tianlin-wang/rfid_reader_with_esp32/README.md

# 智能收作业系统（离线版）

基于 **ESP32-S3 + PN532** 的课堂作业登记器：学生把贴了 NTAG 标签的作业本往读卡器上一放，屏幕立刻登记，全程离线，数据存在 SD 卡里断电不丢。

> 早先版本只是个"读卡显示 UID"的演示器，现在是一个完整的收作业工具。老版本的功能（读卡 / NTAG 写卡）都保留了。

---

## 功能

- **刷卡登记** —— 作业本贴上 NTAG 标签，刷一下即登记，屏幕显示姓名、提交结果和全班进度条
- **专属编号** —— 每个学生自动发一个编号（`0001` 起），既存名单也写进卡片，刷卡时两边核对
- **防拿错卡** —— 卡里编号和名单对不上会当场拦下，并告诉你是谁的卡
- **未交名单** —— 按 C 键随时翻看谁还没交，分页显示
- **多次作业** —— 最多 30 次，全部交齐后自动进入下一次
- **断电记忆** —— 名单和提交记录都写成 CSV 存在 SD 卡里，拔电重启接着用
- **中文双字库** —— SD 卡放 `font.vlw`（抗锯齿）优先，不插卡自动回退内置 16×16 点阵
- **写卡模式** —— 批量给空白标签发编号，或给已登记的卡补写

## 硬件接线

### ST7789 TFT (240×240) —— SPI2 (FSPI)

| TFT Pin | ESP32 Pin |
|---|---|
| SCK | 4 |
| MOSI | 5 |
| RST | 6 |
| DC | 7 |
| CS | 10 |
| BLK | 13 |

### PN532 (SPI 模式) —— 软件 SPI

| PN532 Pin | ESP32 Pin |
|---|---|
| SCK | 17 |
| MISO | 18 |
| MOSI | 8 |
| SS | 3 |
| IRQ | 11 |
| RST | 12 |

> PN532 模块上的拨码开关要拨到 SPI 模式（SEL1=0，SEL2=1）。

### SD 卡 —— SPI（HSPI / 下标 1）

| SD Pin | ESP32 Pin |
|---|---|
| SCK | 42 |
| MISO | 41 |
| MOSI | 40 |
| CS | 39 |

> **注意**：屏幕和 SD 卡必须走不同的 SPI 主机（详见下面那段）。改成同一个主机会因为两边各自调用 `spi_bus_initialize()` 互相冲突，**SD 卡直接挂不上**。

### 按键（另一端接 GND，内部上拉）

| 按键 | ESP32 Pin | 功能 |
|---|---|---|
| A | 14 | 短按 = 开新作业 / 确认；**长按 1 秒 = 清空全部记录** |
| B | 15 | 上翻页 / 取消 |
| C | 16 | 切换到未交名单 / 下翻页 |

---

> **★ SPI 主机分配（ESP32-S3，别改错）**
>
> Arduino 核心在 S2/S3 上只维护 2 条 SPI 总线，`_spi_bus_array[]` 的**下标**是：
>
> | 下标 | 寄存器 | 宏 | 谁在用 |
> |------|--------|-----|--------|
> | 0 | `SPI2_BASE` | `FSPI` | 屏幕 ST7789（LovyanGFX 内部映射到下标 0）|
> | 1 | `SPI3_BASE` | `HSPI` | SD 卡 |
>
> **注意**：`FSPI`/`HSPI` 里的数字是**数组下标**，不是 IDF 的 `spi_host_device_t`。
> 千万别写 `SPIClass sdSPI(SPI1_HOST)` —— `SPI1_HOST=0` 会落到下标 0（`SPI2_BASE`），
> 正好和屏幕撞车，两个库各配一遍同一外设 → 屏幕/SD 全崩。
>
> ```cpp
> SPIClass sdSPI(HSPI);   // ← SD 卡用下标 1
> ```
>
> 补充：ESP32-S3 的 `SOC_SPI_PERIPH_NUM = 3`，IDF 里 `SPI1_HOST=0 / SPI2_HOST=1 / SPI3_HOST=2`，
> 但 Arduino 的 `FSPI/HSPI` 宏映射到的是 **SPI2_BASE / SPI3_BASE**（跳过了 SPI1）。
> 两套编号体系很容易混，改代码前先确认一下。

### ⚠️ SD 卡：是板载卡槽还是外接模块？

`ESP32S3 CAM LCD` 板子上**自带一个 microSD 卡槽**，它的引脚是焊死的。
如果你把卡插在**板载卡槽**里，就必须用**板子的 SD 引脚**（不是下面表里自己接的那组）。
`tools/inspect_vlw.py` 也支持直接扫盘符：`python tools/inspect_vlw.py E:`。

挂载失败时按顺序查：

| 现象 | 原因 | 处理 |
|---|---|---|
| 5 个频率全失败 | 卡是 **exFAT** | 格式化成 **FAT32**（单分区）|
| 5 个频率全失败 | 接线/引脚不对 | 确认是板载卡槽还是外接模块，引脚别搞反 |
| 5 个频率全失败 | 供电不足 | 带 AMS1117 稳压器的模块要 5V |

---

## 依赖库

Arduino IDE 库管理器里装：

- **Adafruit PN532** — by Adafruit
- **LovyanGFX** — by lovyan03

`SPI.h`、`SD.h`、`driver/gpio.h` 都是板载自带的。

---

## 串口连不上 / 没反应怎么查

本机接线：**USB-TTL 桥（CH340）接 UART0**，即 GPIO44(收) / GPIO43(发)。
`Serial0` 就是 UART0；`Serial`（USB CDC）在这块板子上用不了，固件默认也不走它。

### 1. 先看端口对不对

设备管理器 / 终端里查：

```
USB-SERIAL CH340 (COM3)    <- 实际是这个
```

> `参数.xlsx` 里写的 COM4 是旧值，**别照着选**。
> Arduino IDE 右下角或「工具 → 端口」里选实际枚举出来的那个。

### 2. 波特率 115200

UART0 是真串口，波特率必须对。串口监视器右下角设置成 **115200**。

### 3. 烧录完按一下 RESET

固件只在开机时打一次 banner。中途打开监视器看不到是正常的——
所以固件加了**每 5 秒一次的心跳**：

```
[alive] t=5s heap=186KB mode=刷卡登记 sd=OK nfc=OK students=0
[alive] t=10s heap=186KB mode=刷卡登记 sd=OK nfc=OK students=0
```

看到这行 = 串口通。看不到 = 端口/波特率/接线有一处不对。

### 4. 还是没反应？按这个顺序排

| 现象 | 原因 | 怎么办 |
|---|---|---|
| 监视器一片空白，但屏幕正常显示 | 端口选错 / 波特率不对 | 回到第 1、2 步 |
| 有心跳但敲命令没反应 | 串口监视器行尾设成了 `No line ending` | 改成 `Both NL & CR`；固件已做超时兜底，但仍建议改 |
| 烧录时提示找不到端口 | CH340 驱动没装 | 装 CH340 驱动 |
| 板子上电完全没反应（屏幕也不亮） | 固件没跑起来 | 看屏幕右下角有没有绿点闪烁（心跳），有就说明程序活着 |

### 5. 桥接芯片不在默认引脚上？

UART0 默认是 GPIO44(收)/GPIO43(发)。如果你那块板的 USB-TTL 桥接到了别的引脚，
改 `sketch_sep6a.ino` 顶部这两行（RX 在前、TX 在后）：

```cpp
#define UART0_RX_PIN -1
#define UART0_TX_PIN -1
```

比如桥接在 GPIO11/12：`#define UART0_RX_PIN 11` / `#define UART0_TX_PIN 12`。

---

## 编译烧录

1. Arduino IDE 开发板选 **ESP32S3 Dev Module**（参照根目录 `参数.xlsx` 的完整配置：16MB Flash、QIO 80MHz、USB CDC On Boot 启用等）
2. 打开 `sketch_sep6a.ino` 编译烧录
3. 打开 **串口监视器**，波特率 **115200**

> `font_cn.h` 约 770 KB 源码 / 120 KB flash，编译会慢一点，属正常现象。

### ⚠️ 两个会让人怀疑人生的编译坑（已踩过）

**1. 文件开头不能有 UTF-8 BOM**

`sketch_sep6a.ino` 一旦带 BOM（`EF BB BF`），Arduino 的预处理会把 BOM 当成一个
不可见字符拼在第一行 `#define` 前面，于是报：

```
sketch_sep6a.ino:1:4: error: stray '#' in program
sketch_sep6a.ino:1:1: error: '<U+FEFF>' does not name a type
```

更坑的是**这一个 BOM 会干掉整个文件里所有的 `#define`**，于是后面跟着一串
`TFT_SCK was not declared`、`HardwareI2C does not name a type`、
`invalid new-expression of abstract class type`……看起来像几十个错误，其实只有一个原因。

用 VS Code / Notepad++ 编辑时请确认编码是 **UTF-8（无 BOM）**。
检查办法（PowerShell）：

```powershell
$b=[IO.File]::ReadAllBytes("sketch_sep6a.ino")[0..2]
if($b[0]-eq 0xEF -and $b[1]-eq 0xBB -and $b[2]-eq 0xBF){"有BOM"}else{"没BOM"}
```

**2. `#include <SD.h>` 必须写在 `#include <LovyanGFX.hpp>` 之前**

LovyanGFX 是靠 `#if defined(_SD_H_)` 判断"用户用了 SD 库"，才去生成
`DataWrapperT<fs::SDFS>` 这个特化。如果 `LovyanGFX.hpp` 先被包含，`_SD_H_`
还没定义，特化就不会生成，`lcd.loadFont(SD, path)` 会报：

```
invalid new-expression of abstract class type 'lgfx::v1::DataWrapperT<fs::SDFS>'
```

当前 `.ino` 顶部的顺序已经是 `SPI.h → SD.h → Adafruit_PN532.h → LovyanGFX.hpp`，
**别去动这个顺序**。

---

## 使用流程

### 第一次：登记学生

1. SD 卡插好，上电。检测不到名单会自动进入**登记模式**
2. 依次刷每个学生的贴纸，串口监视器输入 `name=张三`
3. 全部录完输入 `d` 保存退出

串口命令（登记模式下）：

| 命令 | 作用 |
|---|---|
| `name=名字` | 给刚刷的贴纸命名并加入名单 |
| `d` | 完成登记，保存到 SD 卡 |
| `list` | 打印当前名单 |
| `clear` | 清空名单 |

### 日常：收作业

| 操作 | 效果 |
|---|---|
| 刷作业本 | 登记，屏幕绿字"提交成功" + 进度条 |
| 重复刷 | 黄字提示"这次已经交过了"，不会重复计数 |
| 刷陌生卡 | 红字提示"未登记的卡"，并显示 UID |
| 按 C | 查看未交名单，B/C 翻页 |
| 全部交齐 | 自动跳到下一次作业 |
| 按 A | 确认后手动开新作业 |
| **长按 A** | 清空所有作业记录（名单保留） |

### 串口模式切换（任何时候）

| 命令 | 作用 |
|---|---|
| `s` | 进入登记模式 |
| `w` | 进入写卡模式（发编号 / 补写） |
| `r` | 回到刷卡登记 |
| `t` | 状态页：看各模块运行状况（没指示灯就看这个） |
| `probe` | 读卡器自检：连扫 10 秒，打印每张卡的 UID 和卡内编号 |
| `list` | 查看名单（含编号） |
| `h` | 命令帮助 |

---

## 硬件没到齐怎么先跑起来

按键和读卡器都不影响开机：**PN532 检测不到时不再卡死**，而是进入「无卡模式」——屏幕、中文字库、SD 存档、名单管理全部正常工作，只是读不到真实卡片。

所有按键操作都有对应的串口命令，没按键时直接敲命令就行：

| 按键 | 串口命令 | 效果 |
|---|---|---|
| A（短按） | `n` | 开新作业 / 确认 |
| B | `u` | 上翻页 / 取消 |
| C | `m` | 未交名单 / 下翻页 |

模拟刷卡（读卡器没到时用）：

```
sim=张三          # 模拟刷张三的卡，走完整登记流程
sim=04 A2 3F 1B  # 模拟刷指定 UID
sim?             # 模拟刷一张未登记的卡
```

其它命令：`s` 登记模式、`w` 写卡模式、`r` 回刷卡界面、`probe` 读卡器自检、`h` 帮助。

---

## 读卡器到货后的首次上机检查

按顺序做，每一步都有明确的"对了应该看到什么"。

### 1. 拨码开关拨到 SPI（最容易翻车的一步）

PN532 模块上两个拨码开关，要拨到 **SEL1=0 / OFF，SEL2=1 / ON**。
不同厂家的丝印不一样，如果板子上标的是 `SEL0/SEL1`，按这个表对：

| 想要 | SEL0 | SEL1 |
|---|---|---|
| SPI（我们要的） | 0 | 1 |
| I2C | 1 | 0 |
| HSU 串口 | 0 | 0 |

拨完**必须断电重上电**才生效。

### 2. 接线

最少接 6 根就能验证（`IRQ` 本工程没用到，可以先不接）：

| PN532 | ESP32 |
|---|---|
| VCC | 3.3V（板子带稳压的接 5V 也行，但**别两种同时接**） |
| GND | GND |
| SCK | 17 |
| MISO  | 18 |
| MOSI  | 8 |
| SS | 3 |
| RST | 12 |

> 这四根信号线走的是**软件 SPI**（库里按位模拟），所以任意 GPIO 都行，
> 不必是芯片的硬件 SPI 引脚。

### 3. 编译前先装依赖

`Adafruit_PN532` 会无条件 include `Adafruit_I2CDevice.h`。
库管理器里装 **Adafruit I2C Device**，否则报
`fatal error: Adafruit_I2CDevice.h: No such file`。

### 4. 看开机日志 / 状态页

烧录完打开串口监视器（**115200**）。**正确的**输出是：

```
Init PN532...
PN532 F/W 1.6        <- 这行出现说明读卡器和拨码开关都对
```

如果看到的是
`WARN: PN532 not found - running WITHOUT reader`，
说明没连上，回到第 1 步重新确认开关和接线。

#### 串口不通？先看屏幕上的 RX/TX

固件在**刷卡界面**和**登记界面**底部都常驻一行：

```
RX:0 TX:142 last:'.'
```

| 现象 | 结论 | 怎么办 |
|---|---|---|
| `RX` 一直是 0，但你在串口里敲了字 | **电脑 → 板子** 断了 | 换端口 / 换波特率 / 检查 CH340 的 TX 是否接到板子 **RX(GPIO44)** |
| `TX` 在涨，串口监视器却空白 | **板子 → 电脑** 断了 | 端口选错、TX/RX 接反、或 CH340 没共地 |
| `RX` 在涨，`last` 显示你敲的字符 | 双向都通 | 串口没问题，去查别的 |

> 板子丝印上 **TX=GPIO43、RX=GPIO44**。
> CH340 那头要**交叉**接：CH340 的 TX → 板子 RX，CH340 的 RX → 板子 TX，GND 必须共地。
> 接反的话：板子发的进不了电脑，电脑发的也进不了板子。

#### 板子上没有指示灯怎么看运行状况？

**屏幕就是指示灯。** 开机后屏幕会先弹一个**状态页**，一屏看清每个环节：

```
系统状态
屏幕    OK  ST7789
读卡器  OK  PN532 F/W 1.6     <- 绿=正常，红=没找到
SD卡    OK                    <- 绿=正常，红=挂载失败
字库    vlw (卡上)             <- 黄=退回内置点阵
学生    0 人
作业    第 1 次
已交    0 / 0
t 返回  h 帮助
```

- 一切正常 → 4 秒后自动回到刷卡界面
- **有红字 → 状态页会一直停着不动**，因为出问题的就是它，去修那一项
- 串口随时敲 **`t`** 可以再调出状态页（再敲一次关掉）

串口敲 `t` 还会打印一份更详细的报告：

```
---- 系统状态 ----
  屏幕      : OK  ST7789 240x240
  读卡器    : OK  PN532 F/W 1.6
  SD 卡     : OK
  字库      : vlw（卡上 /font.vlw）
  学生      : 0 人
  当前作业  : 第 1 次，已交 0/0
  界面模式  : 刷卡登记
  运行      : 已启动 12 秒，空闲内存 180 KB
  提示      : t 状态页  h 帮助  probe 读卡器自检  list 名单
-------------------
```

**字库显示"内置点阵"** 说明 SD 卡上没有 `/font.vlw`（或 SD 挂载失败）。
内置点阵能显示中文，只是没有抗锯齿、比较糙。把 `font.vlw` 拷到 SD 卡根目录即可。

#### 想自己加一颗指示灯？

代码里留了接口。把一颗 LED（串 220~330Ω 电阻）接到**任意一个空闲 GPIO** 和 GND 之间，
然后改这一行：

```cpp
#define LED_PIN -1     // 改成你接的那个 GPIO 号，比如 21
```

灯的含义：常亮=一切正常；慢闪=读卡器没接上；快闪=SD 卡挂了；双闪=登记模式。
默认 `-1`（关闭），不接灯也能正常跑。

### 5. 用 probe 确认能读到卡

串口敲 `probe`，它会连续扫 10 秒，把卡放上去：

```
probe: 连续扫描 10 秒，把卡片放上去...
  卡 #1 UID: 04 A2 3F 1B  (4 字节)  卡内无编号（空白卡 / 非本系统）  名单:未登记
probe 结束，共识别 1 张卡
```

一张都没读到时会直接列出排查清单（开关 / 接线 / 卡片类型）。

> 只认 **ISO14443A** 的卡：NTAG213/215/216、Mifare 系列都行；
> **身份证、门禁卡、银行卡读不到**（那些是别的协议或做了加密）。

### 6. 跑通完整流程

```
s            进登记模式
（刷卡）     串口打印 UID，提示输入姓名
name=张三    自动分配编号 0001，写入卡片并读回校验
name=李四    编号 0002，依此类推
d            登记完成，回到刷卡界面
（刷卡）     登记作业，屏幕显示 [0001] 张三 提交成功
m            看谁还没交
```

写进 SD 卡的 `/roster.csv` 长这样：

```
# UID_HEX,SID,NAME
04 A2 3F 1B,1,张三
```

### 7. 验证防拿错卡

把两张卡互换着刷一次，应该弹「编号不符」并提示是哪位同学的卡。。

硬件到齐后接上即可，串口命令和按键可以混用，不需要改代码。

---

## SD 卡上的文件

| 文件 | 内容 |
|---|---|
| `/font.vlw` | 中文字库（可选，没有就用内置点阵）。**文件名不强制**，卡根目录任意 `.vlw` 都会被自动采用 |
| `/roster.csv` | `UID_HEX,编号,姓名` 学生名单（旧的两列格式能自动兼容并补号） |
| `/state.csv` | 当前是第几次作业 |
| `/hw_N.csv` | 第 N 次作业的提交记录（`姓名,UID,是否提交`） |

直接拔卡插电脑就能导出名单做统计。

---

## 专属编号与写卡

每个学生有一个**专属编号**（1~50，按登记顺序自动分配，显示成 `0001` 这样），
这个编号既存在名单里，也**写进卡片**。刷卡时两边一起核对，
能当场抓出「拿错卡」「换卡」的情况。

### 卡片里存了什么

只占 2 页，写入和校验都很快：

| 页 | 内容 |
|----|---|
| 第 8 页 | `'R' 'F' 'I' 'D'` 魔数，一眼认出是我们的卡 |
| 第 9 页 | 版本号 \| 编号高字节 \| 编号低字节 \| 校验和 |

校验和是前 7 个字节按位异或，卡片写坏或读到脏数据时会直接被拦下。

| 型号 | 用户页范围 |
|---|---|
| NTAG213 | 4 ~ 39 |
| NTAG215 | 4 ~ 129 |
| NTAG216 | 4 ~ 225 |

### 怎么发号

**方式一：登记时自动写卡（推荐）**

串口 `s` 进登记模式，刷卡 → 输入 `name=张三`，
系统自动分配编号并**顺手把编号写进这张卡**，写完立刻读回校验。
一张卡一步搞定，不用再单独跑写卡模式。

**方式二：批量写卡 / 补写**

串口 `w` 进写卡模式，一张一张往上放：

- **没登记过的卡** → 自动分配下一个空闲编号并写入
- **已经登记过的卡** → 把它的编号重写回去（卡片蹭坏了、想补号时用）

写卡界面会显示"下一个将分配编号 00XX"，不用记自己数到哪了。

### 刷卡时的核对

UID 对上名单只是第一步，程序还会读回卡内编号再比一次：

| 情况 | 屏幕显示 |
|---|---|
| 编号一致 | 正常记录提交，姓名上方显示 `[0007]` |
| 卡里是别人的编号 | `编号不符`，并直接告诉你是谁的卡 |
| 卡里没编号 | `卡里没有编号`，提示可能没写过 |

这种核对能防止别人替交作业——只拿卡不刷对不上的号会被拦下。

> ⚠️ **依赖提醒**：`Adafruit_PN532` 库会无条件 include `Adafruit_I2CDevice.h`，
> 即使你用软件 SPI 用不到 I2C 也一样。编译报
> `Adafruit_I2CDevice.h: No such file` 时，在库管理器里装一下
> **Adafruit I2C Device** 即可。

---

## 中文字库：vlw 优先，点阵兜底

两种方案会自动选择，**SD 卡上有 `.vlw` 就用 vlw**：

| 方案 | 条件 | 特点 |
|---|---|---|
| **SD 卡 vlw**（优先） | 卡根目录存在 `.vlw` 文件 | 8bit 抗锯齿灰度，观感最好；换字体/字号重新生成就行 |
| **内置点阵**（兜底） | 没插卡 / 卡上没有 `.vlw` | 16×16 点阵编译进 flash，任何情况都能显示中文 |

**文件名不强制叫 `font.vlw`。** 固件优先找 `/font.vlw`；找不到就扫 SD 卡根目录，
拿第一个 `.vlw` 来用（大小写不敏感）。你从网上下载的 VLW 直接丢进卡根目录即可，
不用改名。

开机串口会打印用的是哪一套：

```
Font: vlw loaded (/font.vlw), native line height=16, scale=1.00
Font: no .vlw on card, using built-in bitmap
Font: 这个文件不是 VLW 格式（可能是 .ttf 改了后缀）
```

串口敲 `ls` 可以看卡上到底有什么文件。

### 检查自己下载的 .vlw 能不能用

`tools/inspect_vlw.py` 零依赖，完全照抄 LovyanGFX 的解析算法，
在电脑上就能判断这个字库能不能被板子接受：

```bash
python tools/inspect_vlw.py D:/          # 扫 D 盘根目录所有 .vlw
python tools/inspect_vlw.py D:/your.vlw  # 看单个文件
```

输出示例：

```
字形数 : 3883    格式版本: 0
实际行高: 16   (ascent 13 + descent 3)
理论总长: 929065 字节 / 实际 929065 字节  ->  一致
覆盖  : ASCII 95, 常用汉字 3756, 其它 32
常用字抽查: 全部齐全
行高 16 —— 和 UI 设计的 16px 完全一致，不缩放，效果最好
```

三个红字信号：

| 提示 | 含义 |
|---|---|
| `这不是 VLW，是 TrueType (.ttf)` | 下载的是 .ttf，改后缀没用。要用 `gen_font_cn.py` 转 |
| `理论总长 != 实际大小` | 文件没拷全 / 损坏 |
| `缺这些常用字: …` | 这个 vlw 不含中文，UI 会显示成空白 |

**行高不等于 16 也能用**——固件会自动缩放到 16px，尺寸对但可能略糊。

### ⚠️ 为什么放的是 .vlw 而不是 .ttf

LovyanGFX 的 TTF 解码器在官方仓库的**可选文件** `lgfx_ttffont.hpp` 里，
Arduino 库管理器装的发行版**没有它**。没有它时，库把所有字体文件一律按
VLW 格式解析（见 `lgfx_fonts.cpp` 里的 `#ifdef LGFX_TTFFONT_HPP_`），
往卡里塞 `.ttf` 只会加载失败或显示乱码。

`.vlw` 本来就是「用任意 TTF 在电脑上预渲染出来的字体文件」——
想换微软雅黑、思源黑体等任何字体，改一下生成脚本的 `--font` 参数即可，
效果等同于矢量字体。

### 生成字库

```bash
cd tools
pip install Pillow
python gen_font_cn.py --preview font_preview.png
# 或者直接写进 SD 卡：python gen_font_cn.py --vlw E:\font.vlw
```

脚本一次产出两个文件：

- `font.vlw`（约 900 KB）→ 拷到 SD 卡根目录
- `font_cn.h`（编译进 flash 的点阵兜底，约 120 KB flash）

字符集自动包含：ASCII + GB2312 一级汉字（3755 个）+ 常用标点 +
**扫描 `.ino` 源码里出现过的所有汉字**（以后改 UI 文案也不怕缺字）。
默认源字体 `C:\Windows\Fonts\simhei.ttf`，想换加 `--font` 参数；
字号默认自动选到 16px 行高以内，想指定用 `--size`。
生成后可以用 `verify_vlw.py` 离线渲染检查（它完全照抄库里的解析算法）：

```bash
python verify_vlw.py ../font.vlw vlw_check.png
```

---

## 代码结构

```
sketch_sep6a.ino
├── 引脚定义          屏幕 / PN532 / SD / 按键
├── 数据模型          Student 结构（uid + 编号 + 姓名）、提交位图 (50 人 × 30 次)
├── 按键中断          gpio_get_level + esp_timer_get_time，IRAM 安全
├── 存储层            SD 卡 CSV 读写（roster / state / hw_N）
├── 字库引擎          SD 卡 vlw（抗锯齿）/ 内置 font_cn.h 点阵，自动切换
├── 绘图原语          fillRect / drawFastHLine / printCentered / printRight
├── UI 画面           刷卡 / 未交名单 / 登记 / 写卡 / 编号不符
├── 编号与写卡        nextFreeSid / writeCardSid / readCardSid（含校验和与回读核对）
└── loop()            状态机 + 串口命令解析
```

---

## 已知限制

- 写卡仅支持 **NTAG** 系列（Ultralight 协议），Mifare Classic 写卡暂未加入
- 编号是顺序号（1~50），中途删人不会重排编号，避免已发出的卡对不上
- 字库只收了 GB2312 一级汉字，姓名里出现生僻字会显示成方框
- 刷卡时每次都要读回卡片做编号核对，比只看 UID 慢约 30ms

---

## License

MIT
