tianlin-wang/rfid_reader_with_esp32/tools/font_preview.png

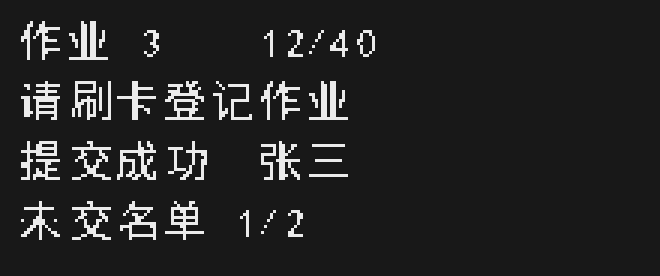
tools/font_preview.png
