tianlin-wang/rfid_reader_with_esp32/tools/vlw_check.png

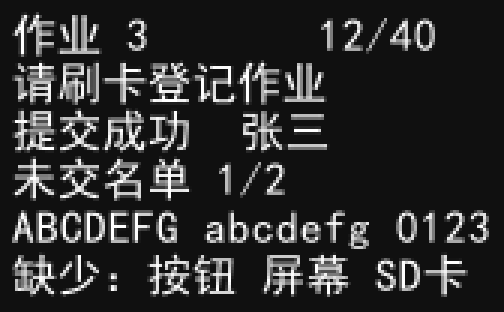
tools/vlw_check.png
