tianlin-wang/rfid_reader_with_esp32/sketch_sep6a.ino

#define TFT_SCK    4
#define TFT_MOSI   5
#define TFT_RST    6
#define TFT_DC     7
#define TFT_CS     10
#define TFT_BLK    13

#define PN532_SCK  17
#define PN532_MISO 18
#define PN532_MOSI 8
#define PN532_SS   3
#define PN532_IRQ  11
#define PN532_RST  12

#define BTN_NEXT  14
#define BTN_UP    15
#define BTN_DOWN  16

// ---- SD 卡 ----
// 现在这组是「外接 SD 模块」的自定接线。
// 如果你把卡插在**板载卡槽**里，卡槽的引脚是焊死的，必须按板子丝印改下面 4 行。
// ⚠️ 板载卡槽如果是 SPI 模式，通常在 GPIO 10/11/12/13 上 ——
//    而这 4 个脚已经被 TFT_CS(10) / PN532_IRQ(11) / PN532_RST(12) / TFT_BLK(13) 占了，
//    会打架。想用板载卡槽，得先把上面的 PN532/TFT 引脚挪开。
#define SD_SCK    42
#define SD_MISO   41
#define SD_MOSI   40
#define SD_CS     39

// ★ 顺序不能改：LovyanGFX 靠 `defined(_SD_H_)` 来决定是否为 fs::SDFS 生成
//   DataWrapperT 特化。SD.h 必须在 LovyanGFX.hpp 之前包含，否则
//   lcd.loadFont(SD, path) 会报 “invalid new-expression of abstract class type”。
#include <SPI.h>
#include <SD.h>
#include <Adafruit_PN532.h>
#include <LovyanGFX.hpp>
#include "driver/gpio.h"
#include "esp_timer.h"

// ============ 串口控制台 ============
// 板上没有指示灯，串口是唯一能看到"系统在干什么"的窗口，这块必须稳。
//
// 本机情况：**只有 UART0 能用**（USB-TTL 桥接在 GPIO44 收 / GPIO43 发）。
//   Serial0 = HardwareSerial(0) = UART0，串口监视器连的就是它。
//   Serial  = USB CDC（USB CDC On Boot=1 时是 HWCDCSerial），本板用不了。
//
// 三个已知的坑：
//  1) Serial0.printf() 没被 HardwareSerial 重写，走的是 Print::printf ->
//     vprintf -> stdout -> SDK 控制台，和 println 不是同一条路，容易混。
//     所以这里自己实现 printf，保证所有输出走同一条路。
//  2) 不能写 while (!Serial0) delay(10); —— USB CDC 那种"等主机连上"的行为
//     会让没开监视器就上电的板子永远卡住，表现为"板子没反应"。
//     所以 operator bool() 永远返回 true。
//  3) 串口监视器行尾设成 "No line ending" 时，readStringUntil('\n') 会一直等。
//     所以自己实现带超时的版本，收到什么算什么。
//
// 想同时开 USB CDC：把 LOG_MIRROR_USB 改成 1（收发都走两个口）。
#define LOG_MIRROR_USB 0

// 如果你的 USB-TTL 桥不是接在芯片默认的 GPIO44(收)/GPIO43(发)，
// 把实际引脚填进来（RX 在前、TX 在后），-1 表示用默认值。
// 例如桥接在 GPIO11/12 时：#define UART0_RX_PIN 11
#define UART0_RX_PIN -1
#define UART0_TX_PIN -1

class DualConsole : public Print {
public:
  void begin(unsigned long baud) {
#if UART0_RX_PIN >= 0 && UART0_TX_PIN >= 0
    Serial0.begin(baud, SERIAL_8N1, UART0_RX_PIN, UART0_TX_PIN);
#else
    Serial0.begin(baud);
#endif
#if LOG_MIRROR_USB && ARDUINO_USB_CDC_ON_BOOT
    Serial.begin(baud);
#endif
  }
  void setTimeout(unsigned long t) { Serial0.setTimeout(t); }

  // 永远 true。不能像 USB CDC 那样"等主机连上才 true"，
  // 否则没开串口监视器就上电的板子会永远卡在 while (!串口) 上，表现为"没反应"。
  operator bool() const { return true; }

  size_t write(uint8_t c) override {
    size_t n = Serial0.write(c);
    txBytes++;
    usbPut((const char *)&c, 1);
    return n;
  }
  size_t write(const uint8_t *buffer, size_t size) override {
    size_t n = Serial0.write(buffer, size);
    txBytes += size;
    usbPut((const char *)buffer, size);
    return n;
  }

  // 自己实现 printf：Print::printf 走 vprintf -> stdout，只会到 UART0
  size_t printf(const char *format, ...) __attribute__((format(printf, 2, 3))) {
    char buf[256];
    va_list ap;
    va_start(ap, format);
    int len = vsnprintf(buf, sizeof(buf), format, ap);
    va_end(ap);
    if (len < 0) return 0;
    if (len > (int)sizeof(buf) - 1) len = (int)sizeof(buf) - 1;
    return write((const uint8_t *)buf, (size_t)len);
  }

  int available() {
    int n = Serial0.available();
#if LOG_MIRROR_USB && ARDUINO_USB_CDC_ON_BOOT
    n += Serial.available();
#endif
    return n;
  }
  int read() {
    if (Serial0.available()) { rxBytes++; lastRx = (uint8_t)Serial0.read(); return lastRx; }
#if LOG_MIRROR_USB && ARDUINO_USB_CDC_ON_BOOT
    if (Serial.available()) { rxBytes++; lastRx = (uint8_t)Serial.read(); return lastRx; }
#endif
    return -1;
  }

  // 按行取命令：两个口的数据混在一起读，谁先来读谁。
  // 没有换行也能用（超时就把已收到的返回），所以串口监视器
  // 的行尾设置成 "No line ending" 也能敲命令。
  String readStringUntil(char term) {
    String s;
    uint32_t t0 = millis();
    while (millis() - t0 < 150) {
      int c = read();
      if (c < 0) { delay(1); continue; }
      if (c == term) break;
      if (c == '\r') continue;
      s += (char)c;
      if (s.length() >= 120) break;
    }
    return s;
  }

  // loop() 里调一次：USB 枚举好之后把缓存的启动日志补发出去
  void pump() {
#if LOG_MIRROR_USB && ARDUINO_USB_CDC_ON_BOOT
    if (usbLive) return;
    if (!Serial) return;
    usbLive = true;
    if (bufLen > 0) {
      Serial.write((const uint8_t *)buf, (size_t)bufLen);
      bufLen = 0;
    }
#endif
  }

  // 收发字节计数：屏幕上直接显示，用来判断串口到底通没通
  // （电脑->板子断了还是板子->电脑断了，看这两个数就知道）
  uint32_t rxBytes = 0;
  uint32_t txBytes = 0;
  uint8_t  lastRx = 0;

private:
  static const int CAP = 2048;
  char buf[CAP];
  int bufLen = 0;
  bool usbLive = false;

  void usbPut(const char *s, size_t n) {
#if LOG_MIRROR_USB && ARDUINO_USB_CDC_ON_BOOT
    if (usbLive) { Serial.write((const uint8_t *)s, n); return; }
    for (size_t i = 0; i < n && bufLen < CAP; i++) buf[bufLen++] = s[i];
#endif
  }
};

DualConsole LOG;

Adafruit_PN532 nfc(PN532_SCK, PN532_MISO, PN532_MOSI, PN532_SS);

// ★ ESP32-S3 上 SPI 的分配（这里踩过坑，务必别改错）
//
// Arduino 核心在 S2/S3 上只维护 2 条 SPI 总线，`_spi_bus_array[]` 的**下标**是：
//   [0] = DR_REG_SPI2_BASE   （宏 FSPI = 0）→ 屏幕在用（LovyanGFX 内部映射到下标 0）
//   [1] = DR_REG_SPI3_BASE   （宏 HSPI = 1）→ SD 卡在用
//
// 注意：FSPI/HSPI 里的数字是**数组下标**，不是 IDF 的 spi_host_device_t！
// 千万别写 `SPIClass sdSPI(SPI1_HOST)` —— SPI1_HOST=0 会落到下标 0（SPI2_BASE），
// 正好和屏幕撞车，两个库各配一遍同一外设 → 屏幕/SD 全崩。
// 就用 Arduino 的宏 HSPI 给 SD，FSPI 给屏幕。
SPIClass sdSPI(HSPI);
bool sdReady = false;

// 读卡器没到货 / 没接时置 false：setup() 不再卡死，进入"无卡模式"，
// 名单、作业状态、屏幕、SD 存档都能先用串口验证。
bool nfcReady = false;

// PN532 固件版本（setup 时读到）。0 = 没读到。
uint32_t nfcFwVer = 0;

// 实际加载的 VLW 文件名（状态页要显示）
char fontName[48] = "";

// 心跳点：屏幕右下角的小方块，每 5 秒翻一次颜色。
// 板上没有指示灯，这是"程序还活着"最直观的证据。
bool beatToggle = false;

// ============ 状态页（顶替不存在的指示灯） ============
// 板子上没有 LED 时，"系统现在跑到哪一步了"只能靠屏幕和串口来判断。
// 开机先弹这个状态页，串口敲 t 随时可以再调出来。
bool statusViewActive = false;
uint32_t statusViewUntil = 0;   // 0 = 一直停着，直到再按一次 t 切回

// 可选状态灯：接一颗 LED（串 220~330Ω 电阻）到任意一个空闲 GPIO 和 GND 之间，
// 然后把下面的数字改成那个 GPIO 号即可。-1 = 关闭（默认）。
// 常亮=正常；慢闪=读卡器没接上；快闪=SD 卡挂载失败；双闪=登记模式。
#define LED_PIN -1

// ============ 颜色 ============
#define BLACK   0x0000
#define WHITE   0xFFFF
#define RED     0xF800
#define GREEN   0x07E0
#define BLUE    0x001F
#define CYAN    0x07FF
#define YELLOW  0xFFE0
#define GRAY    0x8410   // 次要信息（UID、页码），别跟正文抢注意力

// ============ 数据模型 ============
#define MAX_STUDENTS 50
#define MAX_HOMEWORK 30
#define BITS_PER_HW  7

struct Student {
  uint8_t uid[7];
  uint8_t uidLen;
  // 专属编号，1~MAX_STUDENTS，登记时按顺序自动分配。
  // 同时写进卡片用户页，刷卡时读回来和这里比对，能抓出拿错卡/换卡。
  uint16_t sid;
  // 16 字节 = 5 个汉字（UTF-8 3 字节/字）+ 结束符。
  // 原来是 12 字节，只能塞 3 个汉字，四个字的名字会被截断。
  char name[16];
};

enum SystemMode { MODE_CHECKIN, MODE_MISSING, MODE_SETUP, MODE_WRITE, MODE_CONFIRM_NEW };
SystemMode sysMode = MODE_CHECKIN;

Student roster[MAX_STUDENTS];
uint8_t studentCount = 0;
uint8_t currentHW = 0;
uint8_t submissions[MAX_HOMEWORK][BITS_PER_HW];

// ============ 按钮（ISR 置标志，loop 里处理） ============
volatile bool btnNextFlag = false;
volatile bool btnUpFlag = false;
volatile bool btnDownFlag = false;
volatile unsigned long btnNextPressTime = 0;
volatile bool btnNextLongPress = false;

// 中断里不能调 digitalRead() / millis()：它们不在 IRAM 里，
// flash 被占用时会崩。改用 gpio_get_level() 和 esp_timer_get_time()。
static inline unsigned long isrMillis() { return (unsigned long)(esp_timer_get_time() / 1000ULL); }

void IRAM_ATTR isrNext() {
  static unsigned long last = 0;
  unsigned long now = isrMillis();
  if (now - last < 50) return;
  last = now;
  if (gpio_get_level((gpio_num_t)BTN_NEXT) == 0) {
    btnNextPressTime = now;
    btnNextLongPress = false;
  } else if (btnNextPressTime > 0) {
    unsigned long dur = now - btnNextPressTime;
    if (dur > 1000) btnNextLongPress = true;
    else if (dur > 30) btnNextFlag = true;
    btnNextPressTime = 0;
  }
}
void IRAM_ATTR isrUp() {
  static unsigned long last = 0;
  unsigned long now = isrMillis();
  if (now - last < 200) return;
  last = now;
  if (gpio_get_level((gpio_num_t)BTN_UP) == 0) btnUpFlag = true;
}
void IRAM_ATTR isrDown() {
  static unsigned long last = 0;
  unsigned long now = isrMillis();
  if (now - last < 200) return;
  last = now;
  if (gpio_get_level((gpio_num_t)BTN_DOWN) == 0) btnDownFlag = true;
}

// ============ 存储层 (SD Card CSV) ============
// 下面几个函数定义在后面的写卡区，这里先声明
int findStudentBySid(uint16_t sid);
void saveRoster();
uint16_t nextFreeSid();
bool writeCardSid(uint16_t sid);
bool readCardSid(uint16_t *sid);

// 状态页相关（定义在 UI 区，setup/loop 在更后面）
void handleCommand(String cmd);
void handleSerialCommands();
void showStatusView();
void printStatus();
void bootShowStatus();
void ledTick();
void sdLowLevelProbe();

// 低层 SD 探测：绕过 SD 库，直接用 SPI 给卡片发 CMD0/CMD8/ACMD41。
//   CMD0 无应答 -> 接线/供电问题（卡片压根没答话）
//   CMD0 有应答 -> SPI 链路通，挂载失败就是文件系统格式问题（exFAT/NTFS 不认）
uint8_t sdXfer(uint8_t b) { return sdSPI.transfer(b); }

// 发一条 SD 命令，返回 R1。调用者自己读后续的 R3/R7 字节。
// CS 释放前后都要补时钟，否则卡片状态机会卡住。
uint8_t sdCmd(uint8_t cmd, uint32_t arg, uint8_t crc) {
  sdSPI.beginTransaction(SPISettings(400000, MSBFIRST, SPI_MODE0));
  digitalWrite(SD_CS, LOW);
  sdXfer(0xFF);
  sdXfer(0x40 | cmd);
  sdXfer((uint8_t)(arg >> 24)); sdXfer((uint8_t)(arg >> 16));
  sdXfer((uint8_t)(arg >> 8));  sdXfer((uint8_t)arg);
  sdXfer(crc);
  uint8_t r = 0xFF;
  for (int i = 0; i < 32; i++) { r = sdXfer(0xFF); if (r != 0xFF) break; }
  return r;                       // 注意：此处 CS 仍为低，供调用者继续读
}
void sdEndCmd(void) {
  sdXfer(0xFF);
  digitalWrite(SD_CS, HIGH);
  for (int i = 0; i < 8; i++) sdXfer(0xFF);   // CS 释放后补 8 个时钟
  sdSPI.endTransaction();
}

void sdLowLevelProbe() {
  LOG.println("---- SD 低层探测（不走 SD 库，直接发命令）----");
  LOG.printf("  引脚: SCK=%d MISO=%d MOSI=%d CS=%d\n", SD_SCK, SD_MISO, SD_MOSI, SD_CS);
  sdSPI.begin(SD_SCK, SD_MISO, SD_MOSI, SD_CS);
  pinMode(SD_CS, OUTPUT);
  digitalWrite(SD_CS, HIGH);
  for (int i = 0; i < 80; i++) sdXfer(0xFF);   // 上电：CS 高 + 74 个时钟

  // 1) CMD0 复位
  uint8_t r0 = sdCmd(0, 0, 0x95); sdEndCmd();
  LOG.printf("  CMD0  (复位)      -> R1=0x%02X  %s\n", r0,
             (r0 == 0x01) ? "OK 卡片应答" :
             (r0 == 0xFF) ? "无应答 → 接线/供电问题" : "异常");
  if (r0 == 0xFF) {
    LOG.println("  结论：卡片在 SPI 上完全没应答。查：");
    LOG.println("    - SCK/MISO/MOSI/CS 四根线有没有接错或松动（MISO 必须接对）");
    LOG.println("    - VCC/GND 有没有接，GND 要和板子共地");
    LOG.println("    - CS 是否悬空 / 接到别的脚上");
    return;
  }

  // 2) CMD8 电压检查（SDHC/SDXC 必过）
  uint8_t r8 = sdCmd(8, 0x1AA, 0x87);
  uint8_t e0 = sdXfer(0xFF), e1 = sdXfer(0xFF), e2 = sdXfer(0xFF), e3 = sdXfer(0xFF);
  sdEndCmd();
  LOG.printf("  CMD8  (电压检查)  -> R1=0x%02X  回显=%02X%02X%02X%02X  %s\n",
             r8, e0, e1, e2, e3,
             (e2 == 0x01 && e3 == 0xAA) ? "OK SDHC/SDXC 卡" : "异常");

  // 3) CMD58 读 OCR（看卡片接受哪个电压范围，很多卡要先做这步）
  uint8_t r58 = sdCmd(58, 0, 0xFF);
  uint8_t o0 = sdXfer(0xFF), o1 = sdXfer(0xFF), o2 = sdXfer(0xFF), o3 = sdXfer(0xFF);
  sdEndCmd();
  LOG.printf("  CMD58 (读 OCR)    -> R1=0x%02X  OCR=%02X%02X%02X%02X  电压位=%s\n",
             r58, o0, o1, o2, o3,
             (o1 & 0x20) ? "3.2~3.3V" : (o1 & 0x10) ? "3.0~3.1V" : "2.7~3.0V");

  // 4) CMD55 + ACMD41 反复直到就绪
  bool ready = false;
  for (int i = 0; i < 200; i++) {
    uint8_t r55 = sdCmd(55, 0, 0x01); sdEndCmd();
    if (r55 != 0x01 && r55 != 0x00) { LOG.printf("  CMD55 异常 R1=0x%02X\n", r55); break; }
    uint8_t r41 = sdCmd(41, 0x40000000, 0xFF); sdEndCmd();
    if (i < 5) LOG.printf("    第%d次: CMD55=0x%02X ACMD41=0x%02X\n", i + 1, r55, r41);
    if (r41 == 0x00) { ready = true; break; }
    if (r41 != 0x01) { LOG.printf("  ACMD41 异常 R1=0x%02X\n", r41); break; }
    delay(10);
  }
  LOG.printf("  ACMD41(初始化)    -> %s\n", ready ? "OK 卡片就绪" : "超时/失败");

  // 5) 就绪后再读一次 OCR，拿 CCS 位判断卡类型
  if (ready) {
    uint8_t rr = sdCmd(58, 0, 0xFF);
    uint8_t c0 = sdXfer(0xFF), c1 = sdXfer(0xFF), c2 = sdXfer(0xFF), c3 = sdXfer(0xFF);
    sdEndCmd();
    LOG.printf("  CMD58 (卡类型)    -> R1=0x%02X  OCR=%02X%02X%02X%02X  %s\n",
               rr, c0, c1, c2, c3, (c0 & 0x40) ? "CCS=1 SDHC/SDXC" : "CCS=0 SDSC");
    LOG.println("  结论：SPI 链路通、卡片能通信 —— 挂载失败是【文件系统格式】问题：");
    LOG.println("    -> 把卡插回电脑，格式化成 FAT32（exFAT/NTFS ESP32 不认）");
    LOG.println("    -> 卡 >32GB 时 Windows 可能只给 exFAT，要用分区工具强制 FAT32");
  } else {
    LOG.println("  结论：CMD0/CMD8/CMD58 都正常，唯独 ACMD41 过不去 ——");
    LOG.println("    这是【供电掉压】的典型症状：ACMD41 阶段卡片内部初始化会拉高峰值电流。");
    LOG.println("    按可能性排序：");
    LOG.println("    1. 供电：SD 模块的 VCC 单独供电（5V 走稳压器），别从板子 3.3V 取电；");
    LOG.println("       或在模块 VCC-GND 两端并一个 100uF 电解电容，尽量靠近卡片。");
    LOG.println("    2. 线材：杜邦线太长/太细，VCC 和 GND 换粗短线，尽量短。");
    LOG.println("    3. 卡：换一张卡试（部分杂牌卡初始化电流特别大）。");
    LOG.println("    4. 卡本身：拿到电脑上重新格式化成 FAT32 再插。");
  }
  digitalWrite(SD_CS, HIGH);
}

// 挂载 SD 卡。失败时逐个频率重试，并打印卡片信息。
// 有些模块/卡对频率敏感（走线长、模块带稳压器降压），4MHz 不行 1MHz 行。
bool initSD() {
  sdSPI.begin(SD_SCK, SD_MISO, SD_MOSI, SD_CS);

  const uint32_t freqs[] = {4000000, 10000000, 20000000, 40000000, 1000000};
  for (int i = 0; i < (int)(sizeof(freqs) / sizeof(freqs[0])); i++) {
    sdReady = SD.begin(SD_CS, sdSPI, freqs[i]);
    LOG.printf("SD: 试 %lu Hz -> %s\n", (unsigned long)freqs[i], sdReady ? "OK" : "失败");
    if (sdReady) {
      LOG.printf("SD card OK  类型=%d  容量=%llu MB  已用=%llu KB\n",
                 (int)SD.cardType(),
                 (unsigned long long)(SD.cardSize() / 1048576ULL),
                 (unsigned long long)(SD.usedBytes() / 1024ULL));
      return true;
    }
    delay(60);
  }

  LOG.println("SD init FAILED —— 依次排查：");
  LOG.println("  1. 卡必须是 FAT32（Windows 格式化时选 FAT32，exFAT/NTFS 不认）");
  LOG.println("  2. 接线：SCK/MISO/MOSI/CS 四根 + VCC + GND，CS 别悬空");
  LOG.println("  3. 供电：带 AMS1110 稳压器的模块要 5V，只接 3.3V 会读不到卡");
  LOG.println("  4. SPI：屏幕走 FSPI(下标0=SPI2_BASE)，SD 必须走 HSPI(下标1=SPI3_BASE)");
  return false;
}

void uidToHex(uint8_t *uid, uint8_t len, char *buf) {
  buf[0] = 0;
  for (uint8_t i = 0; i < len; i++) {
    if (i > 0) strcat(buf, " ");
    char tmp[4];
    snprintf(tmp, sizeof(tmp), "%02X", uid[i]);
    strcat(buf, tmp);
  }
}

void saveRoster() {
  if (!sdReady) return;
  File f = SD.open("/roster.csv", FILE_WRITE);
  if (!f) { LOG.println("Cannot write roster.csv"); return; }
  f.println("# RFID CheckIn Roster");
  f.println("# UID_HEX,SID,NAME");
  for (uint8_t i = 0; i < studentCount; i++) {
    char uidStr[32];
    uidToHex(roster[i].uid, roster[i].uidLen, uidStr);
    f.print(uidStr); f.print(",");
    f.print(roster[i].sid); f.print(",");
    f.println(roster[i].name);
  }
  f.close();
  LOG.println("roster.csv saved");
}

void loadRoster() {
  if (!sdReady) { studentCount = 0; return; }
  if (!SD.exists("/roster.csv")) { studentCount = 0; return; }

  File f = SD.open("/roster.csv", FILE_READ);
  if (!f) { studentCount = 0; return; }
  studentCount = 0;
  while (f.available() && studentCount < MAX_STUDENTS) {
    String line = f.readStringUntil('\n');
    line.trim();
    if (line.length() == 0 || line[0] == '#') continue;

    int comma = line.indexOf(',');
    if (comma <= 0) continue;
    String uidPart = line.substring(0, comma);
    String rest = line.substring(comma + 1);

    uint8_t uidBuf[7] = {0};
    uint8_t uidLen = 0;
    int idx = 0;
    String token = "";
    for (int i = 0; i < (int)uidPart.length(); i++) {
      char c = uidPart[i];
      if (c == ' ') {
        if (token.length() == 2 && uidLen < 7) {
          uidBuf[uidLen++] = (uint8_t)strtol(token.c_str(), NULL, 16);
        }
        token = "";
      } else token += c;
    }
    if (token.length() == 2 && uidLen < 7) {
      uidBuf[uidLen++] = (uint8_t)strtol(token.c_str(), NULL, 16);
    }
    if (uidLen == 0) continue;

    // 新格式 UID,SID,NAME；旧格式 UID,NAME 只有两列，
    // 此时第二个逗号找不到，就当没有编号、按顺序补一个。
    uint16_t sid = 0;
    String namePart = rest;
    int comma2 = rest.indexOf(',');
    if (comma2 >= 0) {
      sid = (uint16_t)strtol(rest.substring(0, comma2).c_str(), NULL, 10);
      namePart = rest.substring(comma2 + 1);
    }

    memcpy(roster[studentCount].uid, uidBuf, uidLen);
    roster[studentCount].uidLen = uidLen;
    roster[studentCount].sid = sid;
    strncpy(roster[studentCount].name, namePart.c_str(), sizeof(roster[studentCount].name) - 1);
    roster[studentCount].name[sizeof(roster[studentCount].name) - 1] = 0;
    studentCount++;
  }
  f.close();

  // 编号为 0 说明是老格式，按顺序补齐，顺便排掉重复编号
  bool needFix = false;
  for (uint8_t i = 0; i < studentCount; i++) {
    if (roster[i].sid == 0) needFix = true;
  }
  if (needFix) {
    LOG.println("Old roster format, assigning SIDs...");
    uint16_t s = 1;
    for (uint8_t i = 0; i < studentCount; i++) {
      if (roster[i].sid != 0) continue;
      while (s <= MAX_STUDENTS && findStudentBySid(s) >= 0) s++;
      if (s > MAX_STUDENTS) break;
      roster[i].sid = s++;
    }
    saveRoster();
  }
  LOG.printf("Loaded %d students from SD\n", studentCount);
}

void saveAllHomework() {
  if (!sdReady) return;
  File sf = SD.open("/state.csv", FILE_WRITE);
  if (sf) {
    sf.print("current_hw="); sf.println(currentHW);
    sf.close();
  }
  for (uint8_t h = 0; h <= currentHW; h++) {
    char path[24];
    snprintf(path, sizeof(path), "/hw_%d.csv", h + 1);
    File f = SD.open(path, FILE_WRITE);
    if (!f) continue;
    f.printf("# HW %d Submissions\n", h + 1);
    f.println("# NAME,UID,SUBMITTED");
    for (uint8_t i = 0; i < studentCount; i++) {
      char uidStr[32];
      uidToHex(roster[i].uid, roster[i].uidLen, uidStr);
      f.print(roster[i].name); f.print(","); f.print(uidStr); f.print(",");
      f.println(isSubmitted(h, i) ? "1" : "0");
    }
    f.close();
  }
}

void loadAllHomework() {
  if (!sdReady) { currentHW = 0; return; }
  currentHW = 0;
  memset(submissions, 0, sizeof(submissions));

  if (SD.exists("/state.csv")) {
    File sf = SD.open("/state.csv", FILE_READ);
    if (sf) {
      String line = sf.readStringUntil('\n');
      line.trim();
      if (line.startsWith("current_hw=")) {
        currentHW = (uint8_t)line.substring(11).toInt();
        if (currentHW >= MAX_HOMEWORK) currentHW = 0;
      }
      sf.close();
    }
  }

  for (uint8_t h = 0; h <= currentHW; h++) {
    char path[24];
    snprintf(path, sizeof(path), "/hw_%d.csv", h + 1);
    if (!SD.exists(path)) continue;
    File f = SD.open(path, FILE_READ);
    if (!f) continue;
    while (f.available()) {
      String line = f.readStringUntil('\n');
      line.trim();
      if (line.length() == 0 || line[0] == '#') continue;
      int lastComma = line.lastIndexOf(',');
      if (lastComma < 0) continue;
      String submittedStr = line.substring(lastComma + 1);
      int comma2 = line.lastIndexOf(',', lastComma - 1);
      if (comma2 < 0) continue;
      String uidPart = line.substring(comma2 + 1, lastComma);

      uint8_t uidBuf[7] = {0};
      uint8_t uidLen = 0;
      String token = "";
      for (int i = 0; i < (int)uidPart.length(); i++) {
        char c = uidPart[i];
        if (c == ' ') {
          if (token.length() == 2 && uidLen < 7) {
            uidBuf[uidLen++] = (uint8_t)strtol(token.c_str(), NULL, 16);
          }
          token = "";
        } else token += c;
      }
      if (token.length() == 2 && uidLen < 7) {
        uidBuf[uidLen++] = (uint8_t)strtol(token.c_str(), NULL, 16);
      }

      int idx = findStudent(uidBuf, uidLen);
      if (idx >= 0 && submittedStr == "1") {
        uint8_t byteIdx = idx / 8;
        uint8_t bitIdx = idx % 8;
        submissions[h][byteIdx] |= (1 << bitIdx);
      }
    }
    f.close();
  }
  LOG.printf("Loaded HW state: current=%d\n", currentHW + 1);
}

void saveCurrentHWFile() {
  if (!sdReady) return;
  char path[24];
  snprintf(path, sizeof(path), "/hw_%d.csv", currentHW + 1);
  File f = SD.open(path, FILE_WRITE);
  if (!f) return;
  f.printf("# HW %d Submissions\n", currentHW + 1);
  f.println("# SID,NAME,UID,SUBMITTED");
  for (uint8_t i = 0; i < studentCount; i++) {
    char uidStr[32];
    uidToHex(roster[i].uid, roster[i].uidLen, uidStr);
    f.print(roster[i].sid); f.print(",");
    f.print(roster[i].name); f.print(","); f.print(uidStr); f.print(",");
    f.println(isSubmitted(currentHW, i) ? "1" : "0");
  }
  f.close();
}

// ============ 辅助函数 ============
int findStudent(uint8_t *uid, uint8_t len) {
  for (uint8_t i = 0; i < studentCount; i++) {
    if (roster[i].uidLen != len) continue;
    if (memcmp(roster[i].uid, uid, len) == 0) return i;
  }
  return -1;
}

bool isSubmitted(uint8_t hw, uint8_t stuIdx) {
  if (hw >= MAX_HOMEWORK) return false;
  uint8_t byteIdx = stuIdx / 8;
  uint8_t bitIdx = stuIdx % 8;
  return (submissions[hw][byteIdx] >> bitIdx) & 1;
}

void markSubmitted(uint8_t hw, uint8_t stuIdx) {
  if (hw >= MAX_HOMEWORK) return;
  uint8_t byteIdx = stuIdx / 8;
  uint8_t bitIdx = stuIdx % 8;
  submissions[hw][byteIdx] |= (1 << bitIdx);
  if (hw == currentHW) saveCurrentHWFile();
}

uint8_t getSubmittedCount(uint8_t hw) {
  uint8_t cnt = 0;
  for (uint8_t i = 0; i < studentCount; i++) {
    if (isSubmitted(hw, i)) cnt++;
  }
  return cnt;
}

void nextHomework() {
  if (currentHW + 1 < MAX_HOMEWORK) {
    currentHW++;
    memset(submissions[currentHW], 0, BITS_PER_HW);
  }
  saveAllHomework();
}

void resetAll() {
  currentHW = 0;
  for (uint8_t h = 0; h < MAX_HOMEWORK; h++) {
    memset(submissions[h], 0, BITS_PER_HW);
  }
  saveAllHomework();
}



class LGFX : public lgfx::LGFX_Device {
  lgfx::Panel_ST7789   _panel;
  lgfx::Bus_SPI        _bus;
  lgfx::Light_PWM      _light;
public:
  LGFX(void) {
    auto bus = _bus.config();
    bus.spi_host   = SPI2_HOST;
    bus.spi_mode   = 0;
    bus.freq_write = 40000000;
    bus.freq_read  = 16000000;
    bus.pin_sclk   = TFT_SCK;
    bus.pin_mosi   = TFT_MOSI;
    bus.pin_miso   = -1;
    bus.pin_dc     = TFT_DC;
    bus.use_lock   = false;
    _bus.config(bus);
    _panel.setBus(&_bus);

    auto p = _panel.config();
    p.pin_cs       = TFT_CS;
    p.pin_rst      = TFT_RST;
    p.pin_busy     = -1;
    p.memory_width = 240;
    p.memory_height= 320;
    p.panel_width  = 240;
    p.panel_height = 240;
    p.offset_x     = 0;
    p.offset_y     = 0;
    p.invert       = false;
    p.rgb_order    = false;
    p.readable     = false;
    _panel.config(p);

    auto light = _light.config();
    light.pin_bl = TFT_BLK;
    light.invert = false;
    light.freq   = 44100;
    light.pwm_channel = 7;
    _light.config(light);
    _panel.setLight(&_light);

    setPanel(&_panel);
  }
};

static LGFX lcd;

// ============ 字库 ============
// 两套方案，SD 卡上的字库优先，找不到就回退内置点阵：
//   1. SD 卡 /font.vlw —— 8bit 抗锯齿灰度，观感最好
//   2. 内置 16x16 点阵（font_cn.h）—— 编译进 flash，不插卡也能显示中文
//
// ⚠️ 为什么 SD 卡上放的是 .vlw 而不是 .ttf：
//    LovyanGFX 的 TTF 解码器在官方仓库的可选文件 lgfx_ttffont.hpp 里，
//    库管理器装的发行版没有它。没有它时 load_font() 把所有文件都当
//    VLW 解析（看 lgfx_fonts.cpp 的 #ifdef LGFX_TTFFONT_HPP_），
//    塞个 .ttf 进去只会解析失败或显示乱码。
//    .vlw 本来就是"用任意 TTF 预渲染出来的字体文件"，
//    由 tools/gen_font_cn.py 从 SimHei 等字体生成（15px / 行高 16）。
//
// ⚠️ 关键：loadFont() 的第二个参数是"字体格式枚举"，不是字号！
//    旧代码写成 loadFont("/font.ttf", 16) 是把 16 当格式传，编译都过不了。
#include "font_cn.h"

// true  = 走 lcd.print()，用 SD 卡上的 vlw 字库
// false = 走自绘 drawText()，用内置点阵字库
bool useTTF = false;

// 目标行高。vlw 按 15px 生成（ascent 13 + descent 3 = 16），
// 内置点阵也是 16；万一卡里放了别的字号的 vlw，initFont() 会等比缩放。
#define FONT_SIZE 16

// 在升序码点表里二分查找汉字，返回字形下标；找不到返回 -1
static int cjkIndex(uint16_t code) {
  int lo = 0, hi = (int)FONT_CN_CJK_COUNT - 1;
  while (lo <= hi) {
    int mid = (lo + hi) >> 1;
    uint16_t c = font_cjk_codes[mid];
    if (c == code) return mid;
    if (c < code) lo = mid + 1;
    else hi = mid - 1;
  }
  return -1;
}

// 画一个字符；返回它占的宽度（ASCII 8px，汉字 16px）
static int drawGlyph(int16_t x, int16_t y, uint16_t code, uint16_t fg, uint16_t bg) {
  uint16_t buf[FONT_CN_CJK_W * FONT_CN_HEIGHT];

  if (code >= 0x20 && code <= 0x7E) {
    const uint8_t *bmp = font_ascii[code - 0x20];
    for (int r = 0; r < FONT_CN_HEIGHT; r++) {
      uint8_t bits = bmp[r];
      for (int c = 0; c < FONT_CN_ASCII_W; c++)
        buf[r * FONT_CN_ASCII_W + c] = (bits & (0x80 >> c)) ? fg : bg;
    }
    lcd.pushImage(x, y, FONT_CN_ASCII_W, FONT_CN_HEIGHT, buf);
    return FONT_CN_ASCII_W;
  }

  int idx = cjkIndex(code);
  if (idx < 0) {
    // 字库没这个字，画个方框提示，别静默留空白
    lcd.fillRect(x, y, FONT_CN_CJK_W, FONT_CN_HEIGHT, bg);
    lcd.drawRect(x, y, FONT_CN_CJK_W, FONT_CN_HEIGHT, fg);
    return FONT_CN_CJK_W;
  }

  const uint8_t *bmp = font_cjk_bitmap[idx];
  for (int r = 0; r < FONT_CN_HEIGHT; r++) {
    uint16_t bits = ((uint16_t)bmp[r * 2] << 8) | bmp[r * 2 + 1];
    for (int c = 0; c < FONT_CN_CJK_W; c++)
      buf[r * FONT_CN_CJK_W + c] = (bits & (0x8000 >> c)) ? fg : bg;
  }
  lcd.pushImage(x, y, FONT_CN_CJK_W, FONT_CN_HEIGHT, buf);
  return FONT_CN_CJK_W;
}

// 画 UTF-8 字符串，返回结束时的 x 坐标（便于接着画）
static int drawText(int16_t x, int16_t y, const char *s, uint16_t fg, uint16_t bg) {
  int cx = x;
  while (*s) {
    unsigned char c = (unsigned char)*s;
    uint32_t code;
    int n;
    if (c < 0x80)       { code = c & 0x7F; n = 1; }
    else if ((c & 0xE0) == 0xC0) { code = c & 0x1F; n = 2; }
    else if ((c & 0xF0) == 0xE0) { code = c & 0x0F; n = 3; }
    else if ((c & 0xF8) == 0xF0) { code = c & 0x07; n = 4; }
    else                 { code = '?'; n = 1; }
    for (int i = 1; i < n; i++) {
      if (!s[i]) break;
      code = (code << 6) | (s[i] & 0x3F);
    }
    if (cx + FONT_CN_CJK_W > lcd.width()) break;
    cx += drawGlyph(cx, y, (uint16_t)code, fg, bg);
    s += n;
  }
  return cx;
}

// 量一段文字的像素宽度，用来做居中 / 右对齐
static int textWidth(const char *s) {
  if (useTTF) return lcd.textWidth(s);
  int w = 0;
  while (*s) {
    unsigned char c = (unsigned char)*s;
    if (c < 0x80)       { w += FONT_CN_ASCII_W; s += 1; }
    else if ((c & 0xE0) == 0xC0) { w += FONT_CN_CJK_W; s += 2; }
    else if ((c & 0xF0) == 0xE0) { w += FONT_CN_CJK_W; s += 3; }
    else if ((c & 0xF8) == 0xF0) { w += FONT_CN_CJK_W; s += 4; }
    else                 { w += FONT_CN_ASCII_W; s += 1; }
  }
  return w;
}

void st7789Init() {
  lcd.init();
  lcd.setRotation(0);
  lcd.fillScreen(BLACK);
  lcd.setTextColor(WHITE, BLACK);
  lcd.setFont(&fonts::Font0);
}

// 列出 SD 卡根目录的文件（判断"卡上到底有什么"时很有用）
void listSdFiles(const char *tag) {
  LOG.printf("%s\n", tag);
  File root = SD.open("/");
  if (!root || !root.isDirectory()) {
    LOG.println("  (打不开根目录)");
    if (root) root.close();
    return;
  }
  int n = 0;
  for (File f = root.openNextFile(); f; f = root.openNextFile()) {
    LOG.printf("  %-24s %8lu B%s\n", f.name(), (unsigned long)f.size(),
                   f.isDirectory() ? "  [目录]" : "");
    n++;
    f.close();
  }
  root.close();
  if (n == 0) LOG.println("  (空)");
}

// 判断一个文件是不是 VLW（不是的话多半是 .ttf 改名来的）
bool looksLikeVlw(const char *path) {
  File f = SD.open(path, FILE_READ);
  if (!f) return false;
  uint8_t h[4] = {0, 0, 0, 0};
  f.read(h, 4);
  f.close();
  if (h[0] == 0x00 && h[1] == 0x01) return false;                 // TTF (sfnt)
  if (h[0] == 'O' && h[1] == 'T' && h[2] == 'T' && h[3] == 'O') return false;  // OTF
  if (h[0] == 't' && h[1] == 'r' && h[2] == 'u' && h[3] == 'e') return false;  // TrueType
  if (h[0] == 'w' && h[1] == 'O' && h[2] == 'F' && h[3] == 'F') return false;  // WOFF
  if (h[0] == 'w' && h[1] == 'O' && h[2] == 'F' && h[3] == '2') return false;  // WOFF2
  return true;
}

// 必须在 initSD() 之后调用：SD 卡上有没有字库到这时才知道
void initFont() {
  useTTF = false;
  fontName[0] = 0;

  if (!sdReady) {
    LOG.println("Font: no SD card, fall back to built-in 16x16 bitmap");
    return;
  }

  // 只认 vlw。loadFont() 没装 TTF 解码器时会把一切当 VLW 解析，
  // 别放 .ttf/.otf 进卡，会乱码。
  // 优先 /font.vlw；没有就扫根目录，把第一个 .vlw 拿来用（文件名不用改）。
  char path[48] = "";
  if (SD.exists("/font.vlw")) {
    strcpy(path, "/font.vlw");
  } else {
    File root = SD.open("/");
    if (root && root.isDirectory()) {
      for (File f = root.openNextFile(); f; f = root.openNextFile()) {
        if (!f.isDirectory()) {
          const char *n = f.name();
          size_t len = strlen(n);
          if (len > 4 && len < 40) {
            bool isV = (n[len-4] == '.') &&
                       (n[len-3] == 'v' || n[len-3] == 'V') &&
                       (n[len-2] == 'l' || n[len-2] == 'L') &&
                       (n[len-1] == 'w' || n[len-1] == 'W');
            if (isV) { snprintf(path, sizeof(path), "/%s", n); f.close(); break; }
          }
        }
        f.close();
      }
      root.close();
    }
  }

  if (path[0] == 0) {
    LOG.println("Font: no .vlw on card, using built-in bitmap");
    listSdFiles("Font: 卡上现在的文件:");
    LOG.printf("Font: built-in bitmap (%d ASCII + %d CJK)\n",
                   FONT_CN_ASCII_COUNT, FONT_CN_CJK_COUNT);
    return;
  }

  LOG.printf("Font: try %s...\n", path);
  if (!looksLikeVlw(path)) {
    LOG.println("Font: 这个文件不是 VLW 格式（可能是 .ttf 改了后缀）");
    LOG.println("Font: 请用 tools/gen_font_cn.py 生成真正的 font.vlw");
    listSdFiles("Font: 卡上现在的文件:");
    return;
  }

  if (lcd.loadFont(SD, path)) {
    // setTextSize 是"倍率"不是像素！VLW 自带行高，按行高等比缩放到 FONT_SIZE，
    // 这样就算以后重新生成了别的字号的 vlw，UI 的 16px 行距也不会乱。
    float h = (float)lcd.fontHeight();
    if (h > 1.0f) lcd.setTextSize((float)FONT_SIZE / h);
    useTTF = true;
    snprintf(fontName, sizeof(fontName), "%s", path);
    LOG.printf("Font: vlw loaded (%s), native line height=%.0f, scale=%.2f\n",
                   path, h, (h > 1.0f) ? (float)FONT_SIZE / h : 1.0f);
    return;
  }
  LOG.println("Font: load failed (文件损坏或字形表为空?)");
  listSdFiles("Font: 卡上现在的文件:");
}

void fillColor(uint16_t c) { lcd.fillScreen(c); }
void fillRect(int16_t x, int16_t y, int16_t w, int16_t h, uint16_t c) {
  if (x + w <= 0 || y + h <= 0 || x >= lcd.width() || y >= lcd.height()) return;
  lcd.fillRect(x, y, w, h, c);
}
void drawPixel(int16_t x, int16_t y, uint16_t c) { lcd.drawPixel(x, y, c); }
void drawFastHLine(int16_t x, int16_t y, int16_t w, uint16_t c) { lcd.drawFastHLine(x, y, w, c); }

uint16_t _fgColor = WHITE, _bgColor = BLACK;
int16_t _cx = 0, _cy = 0;

void setTextColor(uint16_t c) {
  _fgColor = c;
  if (useTTF) lcd.setTextColor(c, _bgColor);
}
void setTextBackground(uint16_t c) {
  _bgColor = c;
  if (useTTF) lcd.setTextColor(_fgColor, c);
}
void setCursor(int16_t x, int16_t y) {
  _cx = x; _cy = y;
  if (useTTF) lcd.setCursor(x, y);
}
void printStr(const char *s) {
  if (useTTF) { lcd.print(s); return; }   // TTF：交给 LovyanGFX 渲染
  _cx = drawText(_cx, _cy, s, _fgColor, _bgColor);
}
void printNum(uint32_t n, int base = 10) {
  char b[12];
  if (base == 16) snprintf(b, sizeof(b), "%X", n);
  else snprintf(b, sizeof(b), "%u", n);
  printStr(b);
}
// 居中画一行（y 为行顶），返回占用的宽度
// ★ 必须走 printStr / lcd.print 这条路，不能直接调 drawText ——
//   drawText 是内置 16x16 点阵渲染器，早先这里写死了它，
//   结果 SD 卡上的 VLW 字库加载成功了却从来没用上，
//   整个界面一直是"内置字体"。现在统一交给 printStr。
int printCentered(int16_t y, const char *s) {
  int w = textWidth(s);
  int x = (lcd.width() - w) / 2;
  if (x < 0) x = 0;
  if (useTTF) {
    lcd.setCursor(x, y);
    lcd.print(s);
  } else {
    drawText(x, y, s, _fgColor, _bgColor);
  }
  return w;
}
// 右对齐，右边距 pad
int printRight(int16_t y, const char *s, int16_t pad) {
  int w = textWidth(s);
  int x = lcd.width() - w - pad;
  if (x < 0) x = 0;
  if (useTTF) {
    lcd.setCursor(x, y);
    lcd.print(s);
  } else {
    drawText(x, y, s, _fgColor, _bgColor);
  }
  return w;
}

// 屏幕上的串口收发统计。板子接在电脑上看不到串口时，
// 靠这一行判断是"电脑->板子"断了还是"板子->电脑"断了。
void drawSerialStat(int16_t y) {
  char buf[40];
  char c = (LOG.lastRx >= 32 && LOG.lastRx < 127) ? (char)LOG.lastRx : '.';
  snprintf(buf, sizeof(buf), "RX:%lu TX:%lu last:'%c'",
           (unsigned long)LOG.rxBytes, (unsigned long)LOG.txBytes, c);
  (void)0;
  setTextColor(GRAY);
  printCentered(y, buf);
}

// ============ UI ============
enum ViewMode { VIEW_CHECKIN, VIEW_MISSING };
ViewMode currentView = VIEW_CHECKIN;
uint8_t missingPage = 0;

#define HEADER_H 22   // 顶栏高度，16px 字高 + 上下各 3px 留白

void drawHeader() {
  fillRect(0, 0, 240, HEADER_H, BLUE);
  setTextBackground(BLUE);          // 点阵要填背景色，顶栏上必须跟蓝底一致
  setTextColor(WHITE);
  setCursor(4, 3);
  printStr("作业");
  printNum(currentHW + 1);

  char right[16];
  snprintf(right, sizeof(right), "%d/%d", getSubmittedCount(currentHW), studentCount);
  printRight(3, right, 6);

  setTextBackground(BLACK);
}

void showCheckInView() {
  fillColor(BLACK);
  setTextBackground(BLACK);
  drawHeader();
  drawFastHLine(0, HEADER_H, 240, CYAN);

  setTextColor(CYAN);
  printCentered(66, "请刷卡登记");

  char line[24];
  snprintf(line, sizeof(line), "第 %d 次作业", currentHW + 1);
  setTextColor(WHITE);
  printCentered(96, line);

  if (nfcReady) {
    char cnt[24];
    snprintf(cnt, sizeof(cnt), "已交 %d / %d", getSubmittedCount(currentHW), studentCount);
    setTextColor(GREEN);
    printCentered(138, cnt);
  } else {
    setTextColor(RED);
    printCentered(138, "读卡器未连接");
  }

  setTextColor(YELLOW);
  printCentered(184, "n开新 u上翻 m名单 h帮助");
  drawSerialStat(210);
}

// ============ 状态页 ============
// 一屏看清：屏幕 / 读卡器 / SD 卡 / 字库 / 名单 / 作业 各到哪一步了。
void statusRow(int16_t y, const char *label, const char *value, uint16_t vc) {
  setTextColor(GRAY);
  setCursor(4, y);
  printStr(label);
  setTextColor(vc);
  setCursor(58, y);
  printStr(value);
}

void showStatusView() {
  statusViewActive = true;
  fillColor(BLACK);
  setTextBackground(BLACK);
  setTextColor(YELLOW);
  printCentered(2, "系统状态");
  drawFastHLine(0, 20, 240, CYAN);

  char buf[32];

  statusRow(26, "屏幕", "OK  ST7789", GREEN);

  if (nfcReady) {
    snprintf(buf, sizeof(buf), "OK  PN532 F/W %d.%d",
             (nfcFwVer >> 16) & 0xFF, (nfcFwVer >> 8) & 0xFF);
    statusRow(52, "读卡器", buf, GREEN);
  } else {
    statusRow(52, "读卡器", "未找到！", RED);
  }

  if (sdReady) {
    statusRow(78, "SD卡", "OK", GREEN);
  } else {
    statusRow(78, "SD卡", "挂载失败！", RED);
  }

  if (useTTF) {
    // 文件名可能很长，截断一下免得撑破 240 宽
    char fn[24];
    snprintf(fn, sizeof(fn), "%s", fontName);
    statusRow(104, "字库", fn, GREEN);
  } else {
    statusRow(104, "字库", "内置点阵", YELLOW);
  }

  snprintf(buf, sizeof(buf), "%d 人", studentCount);
  statusRow(130, "学生", buf, WHITE);

  snprintf(buf, sizeof(buf), "第 %d 次", currentHW + 1);
  statusRow(156, "作业", buf, WHITE);

  snprintf(buf, sizeof(buf), "%d / %d", getSubmittedCount(currentHW), studentCount);
  statusRow(182, "已交", buf, WHITE);

  setTextColor(GRAY);
  printCentered(210, "t 返回  h 帮助");
}

// 当前界面模式的名字
const char *modeName() {
  switch (sysMode) {
    case MODE_CHECKIN:    return "刷卡登记";
    case MODE_MISSING:    return "未交名单";
    case MODE_SETUP:      return "登记模式";
    case MODE_WRITE:      return "写卡模式";
    case MODE_CONFIRM_NEW:return "确认开新作业";
  }
  return "?";
}

// 串口版状态报告，比屏幕上更详细
void printStatus() {
  LOG.println("---- 系统状态 ----");
  LOG.printf("  屏幕      : OK  ST7789 240x240\n");
  if (nfcReady) {
    LOG.printf("  读卡器    : OK  PN532 F/W %d.%d\n",
                   (nfcFwVer >> 16) & 0xFF, (nfcFwVer >> 8) & 0xFF);
  } else {
    LOG.println("  读卡器    : 未找到 —— 检查接线 + 拨码开关(SPI 模式) + 断电重上电");
  }
  LOG.printf("  SD 卡     : %s\n", sdReady ? "OK" : "挂载失败 —— 检查接线/卡是否插好/是不是 FAT32");
  if (useTTF) LOG.printf("  字库      : %s（卡上）\n", fontName);
  else LOG.println("  字库      : 内置 16x16 点阵（卡上没有 .vlw）");
  LOG.printf("  学生      : %d 人\n", studentCount);
  LOG.printf("  当前作业  : 第 %d 次，已交 %d/%d\n",
                 currentHW + 1, getSubmittedCount(currentHW), studentCount);
  const char *m = modeName();
  LOG.printf("  界面模式  : %s\n", m);
  LOG.printf("  运行      : 已启动 %lu 秒，空闲内存 %lu KB\n",
                 millis() / 1000, ESP.getFreeHeap() / 1024);
  LOG.println("  提示      : t 状态页  h 帮助  probe 读卡器自检  list 名单");
  LOG.println("-------------------");
}

// 可选状态灯。LED_PIN 配成实际 GPIO 号才生效（-1 = 关闭）。
// 常亮=一切正常；慢闪=读卡器没接上；快闪=SD 卡挂了；双闪=登记模式。
void ledTick() {
#if LED_PIN >= 0
  static uint32_t t0 = 0;
  static uint8_t  phase = 255;
  uint32_t now = millis();
  if (now - t0 < 60) return;

  uint8_t want;
  if (!nfcReady)      want = 1;   // 慢闪
  else if (!sdReady)  want = 2;   // 快闪
  else if (sysMode == MODE_SETUP || sysMode == MODE_WRITE) want = 3;  // 双闪
  else                want = 0;   // 常亮

  if (want == 0) {
    if (phase != 0) { digitalWrite(LED_PIN, HIGH); phase = 0; }
    t0 = now;
    return;
  }
  if (want == 1) {            // 1 Hz
    if ((now - t0) >= 500) { digitalWrite(LED_PIN, !digitalRead(LED_PIN)); t0 = now; }
    return;
  }
  if (want == 2) {            // 5 Hz
    digitalWrite(LED_PIN, !digitalRead(LED_PIN));
    t0 = now;
    return;
  }
  // 双闪：亮 60ms 灭 120ms 亮 60ms 灭 720ms
  if (phase == 255) { phase = 0; t0 = now; return; }
  if (now - t0 >= 120) {
    digitalWrite(LED_PIN, !digitalRead(LED_PIN));
    t0 = now;
    phase++;
    if (phase > 3) phase = 0;
  }
#endif
}

void showCheckInResult(int stuIdx, uint8_t *uid, uint8_t uidLen) {
  fillColor(BLACK);
  setTextBackground(BLACK);
  drawHeader();
  drawFastHLine(0, HEADER_H, 240, CYAN);

  if (stuIdx < 0) {
    setTextColor(RED);
    printCentered(50, "未登记的卡");

    char uidStr[32];
    if (uid && uidLen) uidToHex(uid, uidLen, uidStr);
    else snprintf(uidStr, sizeof(uidStr), "--------");
    setTextColor(WHITE);
    printCentered(85, uidStr);

    setTextColor(YELLOW);
    printCentered(145, "串口输入 s");
    printCentered(168, "进入登记模式");
    return;
  }

  char idBuf[32];
  snprintf(idBuf, sizeof(idBuf), "[%04u]", roster[stuIdx].sid);
  setTextColor(GRAY);
  printCentered(30, idBuf);

  setTextColor(WHITE);
  printCentered(56, roster[stuIdx].name);

  if (isSubmitted(currentHW, stuIdx)) {
    setTextColor(YELLOW);
    printCentered(88, "这次已经交过了");
  } else {
    markSubmitted(currentHW, stuIdx);
    setTextColor(GREEN);
    printCentered(88, "提交成功");
  }

  uint8_t submitted = getSubmittedCount(currentHW);
  uint8_t pct = studentCount ? (submitted * 100 / studentCount) : 0;

  // 进度条：外框 + 填充
  lcd.drawRect(20, 120, 200, 12, WHITE);
  uint16_t barW = (uint16_t)submitted * 196 / (studentCount ? studentCount : 1);
  fillRect(22, 122, barW, 8, GREEN);

  char prog[32];
  snprintf(prog, sizeof(prog), "已交 %d/%d  %d%%", submitted, studentCount, pct);
  setTextColor(WHITE);
  printCentered(148, prog);

  setTextColor(CYAN);
  printCentered(180, "继续刷下一本");
}

void showMissingView() {
  fillColor(BLACK);
  setTextBackground(BLACK);

  uint8_t missing[50];
  uint8_t missingIdx = 0;
  for (uint8_t i = 0; i < studentCount && missingIdx < 50; i++) {
    if (!isSubmitted(currentHW, i)) missing[missingIdx++] = i;
  }

  fillRect(0, 0, 240, HEADER_H, RED);
  setTextBackground(RED);
  setTextColor(WHITE);
  setCursor(4, 3); printStr("未交名单");
  char right[16];
  snprintf(right, sizeof(right), "%d人", missingIdx);
  printRight(3, right, 6);
  setTextBackground(BLACK);
  drawFastHLine(0, HEADER_H, 240, RED);

  if (missingIdx == 0) {
    setTextColor(GREEN);
    printCentered(100, "全部交齐！");
    setTextColor(CYAN);
    printCentered(140, "按 A 开新作业");
    return;
  }

  const uint8_t perPage = 10;      // 16px 字高，一屏最多 10 行
  uint8_t totalPages = (missingIdx + perPage - 1) / perPage;
  if (missingPage >= totalPages) missingPage = totalPages - 1;

  uint8_t start = missingPage * perPage;
  uint8_t end = start + perPage;
  if (end > missingIdx) end = missingIdx;

  int row = 28;
  for (uint8_t i = start; i < end; i++) {
    // 左列编号（4 位数字 + 两个空格 = 48px），右列姓名
    char num[12];
    snprintf(num, sizeof(num), "%04u", roster[missing[i]].sid);
    setTextColor(CYAN);
    setCursor(6, row); printStr(num);
    setTextColor(WHITE);
    setCursor(60, row);
    printStr(roster[missing[i]].name);
    row += 19;
  }

  char page[16];
  snprintf(page, sizeof(page), "%d/%d", missingPage + 1, totalPages);
  setTextColor(YELLOW);
  printRight(219, page, 8);
}

void showNewHWConfirm() {
  fillColor(BLACK);
  setTextBackground(BLACK);
  setTextColor(YELLOW);
  printCentered(38, "开始新作业？");
  drawFastHLine(24, 62, 192, YELLOW);

  char cur[24], nxt[24];
  snprintf(cur, sizeof(cur), "当前：第 %d 次", currentHW + 1);
  snprintf(nxt, sizeof(nxt), "新的：第 %d 次", currentHW + 2);
  setTextColor(WHITE);
  printCentered(82, cur);
  setTextColor(CYAN);
  printCentered(108, nxt);

  setTextColor(GREEN);
  printCentered(168, "A 键确认");
  setTextColor(RED);
  printCentered(196, "B 或 C 取消");
}

void showAllDone() {
  fillColor(BLACK);
  setTextBackground(BLACK);
  setTextColor(GREEN);
  printCentered(88, "全部交齐！");
  char line[24];
  snprintf(line, sizeof(line), "第 %d 次作业完成", currentHW + 1);
  setTextColor(CYAN);
  printCentered(130, line);
}

void showSetupMode() {
  fillColor(BLACK);
  setTextBackground(BLACK);

  fillRect(0, 0, 240, HEADER_H, YELLOW);
  setTextBackground(YELLOW);
  setTextColor(BLACK);
  setCursor(4, 3); printStr("登记模式");
  char right[16];
  snprintf(right, sizeof(right), "%d人", studentCount);
  printRight(3, right, 6);
  setTextBackground(BLACK);
  drawFastHLine(0, HEADER_H, 240, YELLOW);

  setTextColor(WHITE);
  printCentered(38, "刷一张新贴纸");
  printCentered(60, "再串口输入姓名");

  drawFastHLine(24, 88, 192, CYAN);
  setTextColor(CYAN);
  printCentered(98, "串口命令");

  setTextColor(GREEN);
  setCursor(18, 120); printStr("name=张三");
  setCursor(18, 140); printStr("d 完成登记");
  setCursor(18, 160); printStr("list 名单");
  setCursor(18, 180); printStr("probe 测读卡器");
  setTextColor(RED);
  setCursor(18, 200); printStr("clear 清空");

  drawSerialStat(222);
}

// ============ 写卡：给每个学生发专属编号并写进卡片 ============
//
// 卡片用户页布局（只占 2 页，写起来快，刷卡校验也快）：
//   第 8 页: 'R' 'F' 'I' 'D'   魔数，一眼认出是我们的卡
//   第 9 页: 版本号 | 编号高字节 | 编号低字节 | 校验和
//   校验和 = 前 7 个字节按位异或，防止卡被写坏或读到脏数据
//
// 为什么不再写那个固定字符串 "HELLO-RFID-TEST-!"：所有卡内容一样，
// 刷卡时没法核对身份，只能靠 UID 猜。

#define NTAG_START_PAGE  8
#define NTAG_MAGIC_P0    'R'
#define NTAG_MAGIC_P1    'F'
#define NTAG_MAGIC_P2    'I'
#define NTAG_MAGIC_P3    'D'
#define CARD_VERSION     1

bool writeMode = false;
uint8_t writeLastUID[7] = {0};
uint8_t writeLastLen = 0;

// 当前待写入的编号；写卡模式下刷卡时分配
uint16_t writePendingSid = 0;

static uint8_t xorSum(const uint8_t *d, uint8_t n) {
  uint8_t s = 0;
  for (uint8_t i = 0; i < n; i++) s ^= d[i];
  return s;
}

// 读回卡内编号。返回 true 表示卡里确实是本系统的卡且校验通过
bool readCardSid(uint16_t *sid) {
  if (!nfcReady) return false;

  uint8_t p0[4] = {0}, p1[4] = {0};
  if (!nfc.ntag2xx_ReadPage(NTAG_START_PAGE, p0)) return false;
  delay(20);
  if (!nfc.ntag2xx_ReadPage(NTAG_START_PAGE + 1, p1)) return false;
  delay(20);

  LOG.print("Card raw: ");
  for (int i = 0; i < 4; i++) LOG.printf("%02X ", p0[i]);
  for (int i = 0; i < 4; i++) LOG.printf("%02X ", p1[i]);
  LOG.println();

  if (p0[0] != NTAG_MAGIC_P0 || p0[1] != NTAG_MAGIC_P1 ||
      p0[2] != NTAG_MAGIC_P2 || p0[3] != NTAG_MAGIC_P3) {
    LOG.println("  -> not our card (magic mismatch)");
    return false;
  }
  if (p1[0] != CARD_VERSION) {
    LOG.printf("  -> version %u, expect %u\n", p1[0], CARD_VERSION);
    return false;
  }
  if (xorSum(p0, 4) != 0 || p1[0] ^ p1[1] ^ p1[2] != p1[3]) {
    LOG.println("  -> CRC failed, card data corrupted");
    return false;
  }

  *sid = ((uint16_t)p1[1] << 8) | p1[2];
  LOG.printf("  -> card sid=%u\n", *sid);
  return true;
}

// 把编号写进卡片，写完立刻读回核对
bool writeCardSid(uint16_t sid) {
  if (!nfcReady) return false;

  uint8_t p0[4] = {NTAG_MAGIC_P0, NTAG_MAGIC_P1, NTAG_MAGIC_P2, NTAG_MAGIC_P3};
  uint8_t p1[4] = {CARD_VERSION, (uint8_t)(sid >> 8), (uint8_t)(sid & 0xFF), 0};
  p1[3] = xorSum(p1, 3);

  LOG.printf("Write sid=%u (hi=%02X lo=%02X crc=%02X)\n",
                 sid, p1[1], p1[2], p1[3]);

  if (!nfc.ntag2xx_WritePage(NTAG_START_PAGE, p0)) return false;
  delay(60);
  if (!nfc.ntag2xx_WritePage(NTAG_START_PAGE + 1, p1)) return false;
  delay(60);

  uint16_t back = 0;
  if (!readCardSid(&back)) {
    LOG.println("  verify read failed");
    return false;
  }
  if (back != sid) {
    LOG.printf("  verify MISMATCH: wrote %u, read %u\n", sid, back);
    return false;
  }
  LOG.println("  verify OK");
  return true;
}

// 下一个可用的顺序编号：跳过已占用的
uint16_t nextFreeSid() {
  for (uint16_t s = 1; s <= MAX_STUDENTS; s++) {
    bool used = false;
    for (uint8_t i = 0; i < studentCount; i++) {
      if (roster[i].sid == s) { used = true; break; }
    }
    if (!used) return s;
  }
  return 0;   // 编号用完了
}

// 按编号反查学生，-1 表示没人
int findStudentBySid(uint16_t sid) {
  for (uint8_t i = 0; i < studentCount; i++) {
    if (roster[i].sid == sid) return i;
  }
  return -1;
}

// 编号核对失败：卡里存的编号和名单不一致，或者卡没写过编号
void showSidMismatch(int stuIdx, uint16_t cardSid, uint8_t *uid, uint8_t len) {
  fillColor(BLACK);
  setTextBackground(BLACK);

  setTextColor(RED);
  printCentered(30, "编号不符");

  char buf[32];
  if (stuIdx >= 0) {
    snprintf(buf, sizeof(buf), "名单编号 %04u", roster[stuIdx].sid);
    setTextColor(WHITE);
    printCentered(70, buf);

    if (cardSid == 0) {
      setTextColor(YELLOW);
      printCentered(92, "卡里没有编号");
    } else {
      snprintf(buf, sizeof(buf), "卡里编号 %04u", cardSid);
      setTextColor(YELLOW);
      printCentered(92, buf);
      // 如果卡里那个编号属于别人，直接告诉你是谁
      int other = findStudentBySid(cardSid);
      if (other >= 0) {
        setTextColor(CYAN);
        snprintf(buf, sizeof(buf), "那是 %s 的卡", roster[other].name);
        printCentered(114, buf);
      }
    }

    setTextColor(WHITE);
    printCentered(146, roster[stuIdx].name);

    setTextColor(GRAY);
    char uidStr[32];
    uidToHex(uid, len, uidStr);
    printCentered(168, uidStr);
  }

  setTextColor(YELLOW);
  printCentered(200, "别代交  拿开重刷");
}

void showWriteMode() {
  fillColor(BLACK);
  setTextBackground(BLACK);

  fillRect(0, 0, 240, HEADER_H, YELLOW);
  setTextBackground(YELLOW);
  setTextColor(BLACK);
  setCursor(4, 3); printStr("写卡模式");
  setTextBackground(BLACK);
  drawFastHLine(0, HEADER_H, 240, YELLOW);

  setTextColor(CYAN);
  printCentered(44, "放上一张空白标签");

  char buf[32];
  snprintf(buf, sizeof(buf), "将分配编号 %04u", writePendingSid);
  setTextColor(WHITE);
  printCentered(84, buf);
  setTextColor(GRAY);
  printCentered(106, "写完刷另一张继续");

  setTextColor(YELLOW);
  printCentered(196, "r 退出写卡");
}

// 写卡结果页。kind: 0=成功新卡 1=重写已有卡 2=失败
void showWriteDone(uint8_t kind, uint16_t sid, uint8_t *uid, uint8_t len) {
  fillColor(BLACK);
  setTextBackground(BLACK);

  setTextColor(kind == 2 ? RED : GREEN);
  printCentered(36, kind == 2 ? "写卡失败" : "写卡成功");

  char buf[32];
  snprintf(buf, sizeof(buf), "编号 %04u", sid);
  setTextColor(WHITE);
  printCentered(76, buf);

  char uidStr[32];
  uidToHex(uid, len, uidStr);
  setTextColor(GRAY);
  printCentered(100, uidStr);

  if (kind == 1) {
    int stu = findStudentBySid(sid);
    if (stu >= 0) {
      setTextColor(CYAN);
      snprintf(buf, sizeof(buf), "%s", roster[stu].name);
      printCentered(128, buf);
    }
  }
  setTextColor(YELLOW);
  printCentered(200, kind == 2 ? "换一张重试" : "换下一张继续");
}

// ============ 主程序 ============

void printSerialHelp() {
  LOG.println("---- 串口命令 ----");
  LOG.println("  n    = 按键A：开新作业 / 确认");
  LOG.println("  u    = 按键B：上翻页 / 取消");
  LOG.println("  m    = 按键C：未交名单 / 下翻页");
  LOG.println("  s    = 进入登记模式（刷卡 + name=姓名，自动发编号并写卡）");
  LOG.println("  w    = 进入写卡模式（批量发编号 / 补写卡）");
  LOG.println("  r    = 回到刷卡界面");
  LOG.println("  list = 查看名单（含编号）");
  LOG.println("  t    = 状态页：屏幕+串口看各模块运行状况（没有指示灯就看这个）");
  LOG.println("  ls   = 列出 SD 卡根目录的文件");
  LOG.println("  sdtest = SD 低层探测：判断是接线问题还是格式问题");
  LOG.println("  probe    = 读卡器自检：连续扫 10 秒，打印每张卡的 UID 和卡内编号");
  LOG.println("  sim=<姓名>   模拟刷某人的卡");
  LOG.println("  sim=<UID>    模拟刷指定 UID");
  LOG.println("  sim?         模拟刷一张陌生卡");
  LOG.println("  h    = 显示本帮助");
}

void enterMode(SystemMode m) {
  sysMode = m;
  // 切界面时把状态页收掉，免得状态页和业务界面互相盖
  statusViewActive = false;
  statusViewUntil = 0;
  switch (m) {
    case MODE_CHECKIN: showCheckInView(); break;
    case MODE_MISSING: showMissingView(); break;
    case MODE_SETUP:   showSetupMode();   break;
    case MODE_WRITE:
      // 进来就把"下一个要发的编号"算好，写卡页要显示它
      writePendingSid = nextFreeSid();
      if (writePendingSid == 0) writePendingSid = MAX_STUDENTS;
      LOG.printf("Write mode, next free sid=%u\n", writePendingSid);
      showWriteMode();
      break;
    case MODE_CONFIRM_NEW: showNewHWConfirm(); break;
  }
}

void handleSerialSetup() {
  static uint8_t setupUID[7] = {0};
  static uint8_t setupUIDLen = 0;
  static bool waitingForName = false;

  while (LOG.available()) {
    char line[64];
    uint8_t n = 0;
    while (LOG.available() && n < sizeof(line) - 1) {
      char c = LOG.read();
      if (c == '\n' || c == '\r') break;
      line[n++] = c;
    }
    line[n] = 0;
    if (n == 0) continue;
    bool handled = false;

    if (strcmp(line, "d") == 0 || strcmp(line, "DONE") == 0) {
      handled = true;
      saveRoster();
      saveAllHomework();
      LOG.printf("Setup done! %d students saved.\n", studentCount);
      enterMode(MODE_CHECKIN);
      return;
    }
    if (strcmp(line, "list") == 0) {
      handled = true;
      LOG.println("Current roster:");
      for (uint8_t i = 0; i < studentCount; i++) {
        LOG.printf("  [%04u] %s (UID:", roster[i].sid, roster[i].name);
        for (uint8_t k = 0; k < roster[i].uidLen; k++) {
          LOG.printf(" %02X", roster[i].uid[k]);
        }
        LOG.println(")");
      }
    }
    if (strcmp(line, "t") == 0 || strcmp(line, "T") == 0) {
      handled = true;
      showStatusView();
      statusViewUntil = 0;
      printStatus();
    }
    if (strcmp(line, "ls") == 0 || strcmp(line, "LS") == 0) {
      handled = true;
      if (!sdReady) LOG.println("ls: SD 卡没挂上");
      else listSdFiles("---- SD 卡根目录 ----");
    }
    if (strcmp(line, "sdtest") == 0) {
      handled = true;
      sdLowLevelProbe();
    }
    if (strncmp(line, "name=", 5) == 0) {
      handled = true;
      if (!waitingForName) {
        LOG.println("No card scanned yet! Scan a sticker first.");
        continue;
      }
      if (studentCount >= MAX_STUDENTS) {
        LOG.println("Roster full!");
        continue;
      }
      // 自动分配下一个空闲编号
      uint16_t sid = nextFreeSid();
      if (sid == 0) {
        LOG.println("No free SID left!");
        continue;
      }
      strncpy(roster[studentCount].name, line + 5, sizeof(roster[studentCount].name) - 1);
      roster[studentCount].name[sizeof(roster[studentCount].name) - 1] = 0;
      memcpy(roster[studentCount].uid, setupUID, setupUIDLen);
      roster[studentCount].uidLen = setupUIDLen;
      roster[studentCount].sid = sid;
      studentCount++;
      saveRoster();
      LOG.printf("Saved: [%04u] %s\n", roster[studentCount - 1].sid,
                     roster[studentCount - 1].name);

      // 顺手把这张卡的编号也写进去，省得再去写卡模式走一遍
      if (nfcReady) {
        if (writeCardSid(sid)) {
          LOG.printf("Card sid written and verified: %u\n", sid);
        } else {
          LOG.printf("WARN: could not write sid to card, run 'w' mode to retry\n");
        }
      }
      waitingForName = false;
      showSetupMode();
    }
    if (strcmp(line, "clear") == 0) {
      handled = true;
      studentCount = 0;
      saveRoster();
      LOG.println("Roster cleared!");
      showSetupMode();
    }

    // 登记模式下没认识的命令，丢给通用命令处理。
    // 少了这一步，在登记界面敲 probe / sim= / h 会一点反应都没有，
    // 看起来就像"串口失灵了"。
    if (!handled) {
      handleCommand(String(line));
    }
  }

  if (!nfcReady) return;

  uint8_t uid[7];
  uint8_t uidLength;
  uint8_t ok = nfc.readPassiveTargetID(PN532_MIFARE_ISO14443A, uid, &uidLength, 50);
  if (ok) {
    static uint8_t lastUID[7] = {0};
    static uint8_t lastLen = 0;
    bool changed = (uidLength != lastLen);
    if (!changed) for (uint8_t i = 0; i < uidLength; i++)
      if (uid[i] != lastUID[i]) { changed = true; break; }

    if (changed) {
      int existing = findStudent(uid, uidLength);
      if (existing >= 0) {
        LOG.printf("Already enrolled: %d. %s\n", existing + 1, roster[existing].name);
      } else {
        memcpy(setupUID, uid, uidLength);
        setupUIDLen = uidLength;
        waitingForName = true;
        LOG.print("Scanned new sticker! UID:");
        for (uint8_t i = 0; i < uidLength; i++) LOG.printf(" %02X", uid[i]);
        LOG.println();
        LOG.println("Type: name=YOUR_NAME");
      }
      memcpy(lastUID, uid, uidLength);
      lastLen = uidLength;
      delay(1500);
    }
  }
}

void setup(void) {
  LOG.begin(115200);
  LOG.setTimeout(50);        // 串口命令按行读，别让 loop 卡在等换行上
  delay(500);
  LOG.println("=== RFID CheckIn ===");

  LOG.println("Init ST7789...");
  st7789Init();
  LOG.println("ST7789 OK");

  LOG.println("Init PN532...");
  pinMode(PN532_RST, OUTPUT);
  digitalWrite(PN532_RST, LOW);
  delay(100);
  digitalWrite(PN532_RST, HIGH);
  delay(200);
  nfc.begin();

  uint32_t ver = nfc.getFirmwareVersion();
  if (!ver) {
    LOG.println("WARN: PN532 not found - running WITHOUT reader");
    LOG.println("      Use 'sim=<name>' to simulate a scan.");
    nfcReady = false;
  } else {
    LOG.printf("PN5%d F/W %d.%d\n", (ver>>24)&0xFF, (ver>>16)&0xFF, (ver>>8)&0xFF);
    nfcFwVer = ver;
    nfc.SAMConfig();
    nfcReady = true;
  }

  LOG.println("Init buttons...");
  pinMode(BTN_NEXT, INPUT_PULLUP);
  pinMode(BTN_UP, INPUT_PULLUP);
  pinMode(BTN_DOWN, INPUT_PULLUP);
  attachInterrupt(digitalPinToInterrupt(BTN_NEXT), isrNext, CHANGE);
  attachInterrupt(digitalPinToInterrupt(BTN_UP), isrUp, FALLING);
  attachInterrupt(digitalPinToInterrupt(BTN_DOWN), isrDown, FALLING);

#if LED_PIN >= 0
  pinMode(LED_PIN, OUTPUT);
  digitalWrite(LED_PIN, LOW);
#endif

  LOG.println("Init SD...");
  initSD();
  initFont();          // 必须在 initSD() 之后

  LOG.println("Loading storage...");
  loadRoster();
  loadAllHomework();
  LOG.printf("Students: %d, Current HW: %d\n", studentCount, currentHW + 1);

  if (studentCount == 0) {
    LOG.println("No students enrolled. Starting setup...");
    LOG.println("Scan each sticker, then type: name=YOUR_NAME");
    LOG.println("Type 'd' when done, 'list' to see roster, 'clear' to reset.");
    enterMode(MODE_SETUP);
    printSerialHelp();
    bootShowStatus();
    return;
  }

  uint8_t submitted = getSubmittedCount(currentHW);
  if (submitted == studentCount && studentCount > 0 && currentHW + 1 < MAX_HOMEWORK) {
    enterMode(MODE_CONFIRM_NEW);
  } else {
    enterMode(MODE_CHECKIN);
  }

  printSerialHelp();
  bootShowStatus();
}

// 开机先弹状态页：全正常 4 秒后自动回主界面；有故障就停在状态页别动，
// 让人一眼看出是哪一环挂了（板子上没指示灯，只能靠这个）。
void bootShowStatus() {
  showStatusView();
  if (nfcReady && sdReady) statusViewUntil = millis() + 4000;
  else statusViewUntil = 0;
  LOG.println("(屏幕上是状态页，串口敲 t 随时再看；h 看命令列表)");
}

// 串口命令处理。
// 登记模式（MODE_SETUP）也走这里 —— 以前登记界面把输入全吃掉了，
// 在登记界面敲 probe / sim= / h 一点反应都没有，看着就像"串口坏了"。
void handleCommand(String cmd) {
  cmd.trim();
  if (cmd.length() == 0) return;
  char c = cmd[0];

  if (c == 'n' || c == 'N') { btnNextFlag = true; LOG.println("[A] next / confirm"); }
  else if (c == 'u' || c == 'U') { btnUpFlag = true; LOG.println("[B] up / cancel"); }
  else if (c == 'm' || c == 'M') { btnDownFlag = true; LOG.println("[C] missing / down"); }
  else if (c == 's' || c == 'S') { enterMode(MODE_SETUP); LOG.println("-> SETUP MODE"); }
  else if (c == 'w' || c == 'W') {
    if (!nfcReady) { LOG.println("Write mode needs PN532, not connected"); }
    else { writeMode = true; writeLastLen = 0; enterMode(MODE_WRITE); LOG.println("-> WRITE MODE"); }
  }
  else if (c == 'r' || c == 'R') { enterMode(MODE_CHECKIN); LOG.println("-> CHECKIN MODE"); }
  else if (c == 'l' || c == 'L') {
    if (!sdReady) { LOG.println("ls: SD 卡没挂上"); }
    else listSdFiles("---- SD 卡根目录 ----");
  }
  else if (cmd.startsWith("sdtest")) {
    sdLowLevelProbe();
  }
  else if (c == 't' || c == 'T') {
    if (statusViewActive) {
      statusViewActive = false;
      statusViewUntil = 0;
      enterMode(sysMode);
      LOG.println("-> 状态页已关闭");
    } else {
      showStatusView();
      statusViewUntil = 0;      // 手动打开就一直停着
      LOG.println("-> 状态页（再敲 t 关闭）");
    }
    printStatus();
  }
  else if (cmd.startsWith("sim=")) {
    String arg = cmd.substring(4);
    arg.trim();
    if (arg.length() == 0) { LOG.println("用法: sim=<姓名> 或 sim=<UID十六进制> 或 sim?"); return; }
    if (arg == "?") { showCheckInResult(-1, nullptr, 0); LOG.println("sim: unknown card"); return; }

    // 先按姓名找，找不到再按 UID 十六进制找
    int idx = -1;
    for (uint8_t i = 0; i < studentCount; i++) {
      if (strcmp(roster[i].name, arg.c_str()) == 0) { idx = i; break; }
    }
    if (idx >= 0) {
      LOG.printf("sim: %s\n", roster[idx].name);
      showCheckInResult(idx, roster[idx].uid, roster[idx].uidLen);
    } else {
      uint8_t uid[7] = {0};
      uint8_t len = 0;
      String tok = "";
      for (int i = 0; i < (int)arg.length(); i++) {
        char ch = arg[i];
        if (ch == ' ' || ch == ':') {
          if (tok.length() == 2 && len < 7) uid[len++] = (uint8_t)strtol(tok.c_str(), NULL, 16);
          tok = "";
        } else tok += ch;
      }
      if (tok.length() == 2 && len < 7) uid[len++] = (uint8_t)strtol(tok.c_str(), NULL, 16);
      if (len == 0) { LOG.println("sim: 找不到这个学生"); return; }
      idx = findStudent(uid, len);
      LOG.printf("sim: UID -> %s\n", idx >= 0 ? roster[idx].name : "UNKNOWN");
      showCheckInResult(idx, uid, len);
    }
    delay(1500);
    enterMode(MODE_CHECKIN);
  }
  else if (cmd.startsWith("probe")) {
    // 读卡器自检：只走读卡链路，不碰名单、不写卡，
    // 用来确认接线和拨码开关对不对。
    if (!nfcReady) {
      LOG.println("probe: PN532 没连上，先查接线和拨码开关");
      return;
    }
    LOG.println("probe: 连续扫描 10 秒，把卡片放上去...");
    unsigned long t0 = isrMillis();
    uint8_t lastUID[7] = {0};
    uint8_t lastLen = 0;
    int seen = 0;
    while (isrMillis() - t0 < 10000) {
      uint8_t uid[7];
      uint8_t len = 0;
      if (nfc.readPassiveTargetID(PN532_MIFARE_ISO14443A, uid, &len, 100)) {
        bool same = (len == lastLen);
        if (same) for (uint8_t i = 0; i < len; i++)
          if (uid[i] != lastUID[i]) { same = false; break; }
        if (!same) {
          LOG.printf("  卡 #%d UID:", ++seen);
          for (uint8_t i = 0; i < len; i++) LOG.printf(" %02X", uid[i]);
          LOG.printf("  (%d 字节)", len);

          uint16_t sid = 0;
          if (readCardSid(&sid)) {
            int owner = findStudentBySid(sid);
            LOG.printf("  编号=%04u", sid);
            if (owner >= 0) LOG.printf("  属于 %s", roster[owner].name);
            else LOG.print("  名单里没人");
          } else {
            LOG.print("  卡内无编号（空白卡 / 非本系统）");
          }
          int known = findStudent(uid, len);
          LOG.printf("  名单:%s\n", known >= 0 ? roster[known].name : "未登记");
          memcpy(lastUID, uid, len);
          lastLen = len;
        }
        delay(300);
      } else {
        lastLen = 0;
        delay(100);
      }
    }
    LOG.printf("probe 结束，共识别 %d 张卡\n", seen);
    if (seen == 0) {
      LOG.println("一张都没读到，依次检查：");
      LOG.println("  1. 拨码开关是不是 SPI 模式");
      LOG.println("  2. SCK/MISO/MOSI/SS 四根线有没有接错或松动");
      LOG.println("  3. 卡片是不是 ISO14443A（NTAG/Mifare）—— 身份证和门禁卡不行");
    }
  }
  else if (c == 'h' || c == 'H') printSerialHelp();
  else LOG.println("未知命令，输入 h 看帮助");
}

// 从串口读命令并逐条执行
void handleSerialCommands() {
  while (LOG.available()) {
    String cmd = LOG.readStringUntil('\n');
    handleCommand(cmd);
  }
}

void loop(void) {
  // 状态页超时自动退回当前界面
  if (statusViewActive && statusViewUntil != 0 && (int32_t)(millis() - statusViewUntil) >= 0) {
    statusViewUntil = 0;
    statusViewActive = false;
    enterMode(sysMode);
  }
  ledTick();
  LOG.pump();          // USB CDC 枚举好了就把缓存的启动日志补发出去

  // 心跳：每 5 秒打一行，串口到底通不通一眼就能看出来。
  // 屏幕右下角的小方块也同步翻色，用来确认主循环还在跑。
  {
    static uint32_t lastBeat = 0;
    if (millis() - lastBeat >= 5000) {
      lastBeat = millis();
      beatToggle = !beatToggle;
      fillRect(231, 229, 8, 8, beatToggle ? GREEN : BLACK);
      LOG.printf("[alive] t=%lus heap=%luKB mode=%s sd=%s nfc=%s students=%d\n",
                 millis() / 1000, ESP.getFreeHeap() / 1024, modeName(),
                 sdReady ? "OK" : "FAIL", nfcReady ? "OK" : "FAIL", studentCount);
    }
  }

  // 长按 A 只在刷卡 / 未交名单 / 开新作业 这三个界面生效。
  // 登记模式和写卡模式下必须忽略，否则登记学生时长按会直接清空整份名单。
  if (btnNextLongPress) {
    btnNextLongPress = false;
    if (sysMode == MODE_CHECKIN || sysMode == MODE_MISSING || sysMode == MODE_CONFIRM_NEW) {
      LOG.println("Long press detected - reset all");
      resetAll();
      enterMode(MODE_CHECKIN);
    } else {
      LOG.println("Long press ignored (not in checkin view)");
    }
  }

  if (sysMode == MODE_SETUP) {
    handleSerialSetup();
    return;
  }

  if (sysMode == MODE_WRITE) {
    while (LOG.available()) {
      char c = LOG.read();
      if (c == 'r' || c == 'R') {
        writeMode = false;
        enterMode(MODE_CHECKIN);
        LOG.println("-> CHECKIN MODE");
      }
    }
    if (!nfcReady) return;

    uint8_t uid[7];
    uint8_t uidLength;
    uint8_t ok = nfc.readPassiveTargetID(PN532_MIFARE_ISO14443A, uid, &uidLength, 50);
    if (ok) {
      bool changed = (uidLength != writeLastLen);
      if (!changed) for (uint8_t i = 0; i < uidLength; i++)
        if (uid[i] != writeLastUID[i]) { changed = true; break; }
      if (changed) {
        LOG.print("Write UID: ");
        for (uint8_t i = 0; i < uidLength; i++) {
          if (uid[i] < 0x10) LOG.print("0");
          LOG.print(uid[i], HEX);
          LOG.print(" ");
        }
        LOG.println();

        // 已经登记过的卡 -> 把它的编号重写回去（补写/修卡）
        // 没登记过的卡 -> 分配一个新编号
        int known = findStudent(uid, uidLength);
        uint16_t sid;
        uint8_t kind;
        if (known >= 0) {
          sid = roster[known].sid;
          kind = 1;
          LOG.printf("Known card #%d, re-write sid=%u\n", known + 1, sid);
        } else {
          sid = nextFreeSid();
          kind = 0;
          LOG.printf("New card, assign sid=%u\n", sid);
        }

        if (sid == 0) {
          LOG.println("No free SID left!");
          showWriteDone(2, 0, uid, uidLength);
        } else if (writeCardSid(sid)) {
          showWriteDone(kind, sid, uid, uidLength);
          LOG.println("WRITE OK");
          // 只有真发了新编号才推进待分配号
          if (kind == 0) {
            writePendingSid = nextFreeSid();
            if (writePendingSid == 0) writePendingSid = MAX_STUDENTS;
            showWriteMode();
          }
        } else {
          showWriteDone(2, sid, uid, uidLength);
          LOG.println("WRITE FAIL");
        }

        memcpy(writeLastUID, uid, uidLength);
        writeLastLen = uidLength;
        delay(2500);
        writeLastLen = 0;      // 清零，下一张卡才算"换卡"
      }
    }
    return;
  }

  if (sysMode == MODE_CONFIRM_NEW) {
    if (btnNextFlag) {
      btnNextFlag = false;
      nextHomework();
      LOG.printf("Started HW %d\n", currentHW + 1);
      enterMode(MODE_CHECKIN);
    }
    if (btnUpFlag || btnDownFlag) {
      btnUpFlag = false; btnDownFlag = false;
      enterMode(MODE_CHECKIN);
    }
    return;
  }


  // 串口命令：n/u/m 等价于按键 A/B/C，没有按键时靠这些操作
  handleSerialCommands();

  if (btnNextFlag) {
    btnNextFlag = false;
    uint8_t submitted = getSubmittedCount(currentHW);
    if (submitted == studentCount && studentCount > 0) {
      if (currentHW + 1 < MAX_HOMEWORK) {
        nextHomework();
        LOG.printf("Auto-advanced to HW %d (all submitted)\n", currentHW + 1);
        showAllDone();
        delay(1500);
        enterMode(MODE_CHECKIN);
      }
    } else if (sysMode == MODE_CHECKIN) {
      enterMode(MODE_CONFIRM_NEW);
    } else if (sysMode == MODE_MISSING) {
      missingPage = 0;
      enterMode(MODE_CHECKIN);
    }
  }

  if (btnUpFlag) {
    btnUpFlag = false;
    if (sysMode == MODE_MISSING && missingPage > 0) {
      missingPage--;
      showMissingView();
    }
  }

  if (btnDownFlag) {
    btnDownFlag = false;
    if (sysMode == MODE_CHECKIN) {
      missingPage = 0;
      enterMode(MODE_MISSING);
    } else if (sysMode == MODE_MISSING) {
      missingPage++;
      showMissingView();
    }
  }

  if (sysMode != MODE_CHECKIN) return;
  if (!nfcReady) return;

  uint8_t uid[7];
  uint8_t uidLength;
  uint8_t ok = nfc.readPassiveTargetID(PN532_MIFARE_ISO14443A, uid, &uidLength, 50);

  static uint8_t lastUID[7] = {0};
  static uint8_t lastLen = 0;
  if (ok) {
    bool changed = (uidLength != lastLen);
    if (!changed) for (uint8_t i = 0; i < uidLength; i++)
      if (uid[i] != lastUID[i]) { changed = true; break; }

    if (changed) {
      int idx = findStudent(uid, uidLength);
      LOG.printf("UID: ");
      for (uint8_t i = 0; i < uidLength; i++) LOG.printf("%02X ", uid[i]);
      if (idx >= 0) LOG.printf("-> %s", roster[idx].name);
      else LOG.print("-> UNKNOWN");

      // 核对卡内编号：UID 对上名单还不够，卡里存的编号也得一致。
      // 不一致说明这张卡是别人的（张冠李戴）或被改写过，必须拦下来。
      if (idx >= 0) {
        uint16_t cardSid = 0;
        if (readCardSid(&cardSid)) {
          if (cardSid == roster[idx].sid) {
            LOG.printf("  [sid %04u OK]", cardSid);
          } else {
            LOG.printf("  [SID MISMATCH! card=%u roster=%u]",
                           cardSid, roster[idx].sid);
            LOG.println("  !! 卡里编号和名单对不上，疑似拿错卡/换卡");
            showSidMismatch(idx, cardSid, uid, uidLength);
            memcpy(lastUID, uid, uidLength);
            lastLen = uidLength;
            delay(2500);
            enterMode(MODE_CHECKIN);
            return;
          }
        } else {
          LOG.println("  [card has no valid sid - was it written?]");
          showSidMismatch(idx, 0, uid, uidLength);
          memcpy(lastUID, uid, uidLength);
          lastLen = uidLength;
          delay(2500);
          enterMode(MODE_CHECKIN);
          return;
        }
      }
      LOG.println();

      showCheckInResult(idx, uid, uidLength);
      memcpy(lastUID, uid, uidLength);
      lastLen = uidLength;
      delay(1500);

      uint8_t submitted = getSubmittedCount(currentHW);
      if (submitted == studentCount && studentCount > 0 && currentHW + 1 < MAX_HOMEWORK) {
        showAllDone();
        delay(1500);
        nextHomework();
        LOG.printf("Auto HW %d started\n", currentHW + 1);
      }
      enterMode(MODE_CHECKIN);
    }
  } else {
    lastLen = 0;
  }
}
