tianlin-wang/rfid_reader_with_esp32/(commit log)

2026-09-25 Initial commit: ESP32 RFID reader with NTAG write support
2026-10-11 feat: 收作业系统 + 内置中文字库（尚未上机测试）
    ⚠️ 本次改动未在真实硬件上验证。PN532 读卡器尚未到货，
    屏幕中文字体、SD 卡挂载（改用 SPI3）、按键中断均只做了代码层校验。
    功能
    - 刷卡登记 / 未交名单 / 多次作业 / 断电记忆（SD 卡 CSV）
    - NTAG 写卡模式保留
    修复
    - 长按 A 清空记录在登记/写卡模式下误触发 → 按模式门控
    - SD 卡与屏幕共用 SPI2_HOST 导致 spi_bus_initialize 冲突 → SD 改 SPI3_HOST
    - 中断内 millis()/digitalRead() 非 IRAM 安全 → esp_timer_get_time()/gpio_get_level()
    - Student.name 12→16 字节（原只够 3 个汉字）
    中文字体
    - 原 loa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
    [sketch_sep6a.ino]
2026-10-11 feat: 支持无按键 / 无读卡器调试（尚未上机测试）
    ⚠️ 仍未在真实硬件上验证。PN532 与按键均尚未到货，
    本改动只是让「屏幕 + SD 卡 + 中文字库」这部分能先跑起来。
    - PN532 检测失败不再 while(1) 卡死，改为降级「无卡模式」，
    屏幕提示「读卡器未连接」，其余功能照常可用
    - 新增串口命令 n / u / m，等价于按键 A / B / C（内部复用按钮标志位）
    - 新增 sim=<姓名> 、sim=<UID> 、sim? 模拟刷卡，走完整登记流程
    - 新增 h 打印命令帮助（开机也会打一次）
    - Serial0.setTimeout(50)，避免按行读命令时 loop 被阻塞
    - 串口命令解析从单字符改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
2026-10-11 feat: SD 卡字库改用 vlw 格式（尚未上机测试）
    LovyanGFX 的 TTF 解码器是官方可选文件 lgfx_ttffont.hpp，库管理器
    装的发行版没有它，load_font() 会把所有文件一律按 VLW 解析，往 SD
    卡放 .ttf 只会失败或乱码。改为放 .vlw（由 TTF 预渲染，效果等同矢量字）。
    - gen_font_cn.py 重写：一次产出 font.vlw（907KB，抗锯齿）+ font_cn.h
    （点阵兜底）；字号自动选到 16px 行高以内（simhei 实选 15px，
    ascent13+descent3=16 正好贴合 UI 行距）
    - 新增 verify_vlw.py：完全照抄库里 VLWfont::loadFont/drawChar 的
    算法离线渲染验证，文件长度、码点升序、渲染结果均已校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
2026-10-11 feat: 每个学生发专属编号并写进卡片，刷卡时核对（尚未上机测试）
    原先写卡模式给所有卡写同一个固定字符串 "HELLO-RFID-TEST-!"，
    卡内容完全一样，刷卡时只能靠 UID 猜是谁，没法核对身份。
    改为每人一个顺序编号（0001 起），既存名单也写进卡片。
    卡片格式（只占 2 页，比原来 16 页快得多）：
    第 8 页 'RFID' 魔数 + 第 9 页 版本|编号高|编号低|异或校验和
    - Student 增加 sid 字段；roster.csv 改三列 UID,编号,姓名，
    旧的两列格式能自动识别并按顺序补号后回写
    - nextFreeSid() 跳过已占用编号发号；findStudentBySid() 反查
    - 登记模式 na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
2026-10-11 feat: 加 probe 读卡器自检命令 + 首次上机检查步骤（尚未上机测试）
    读卡器到货，加一条与名单业务解耦的自检链路，方便确认接线和拨码开关：
    - probe 命令：连续扫 10 秒，打印每张卡的 UID、字节数、卡内编号、
    编号归属、是否已登记；读不到时直接列出排查清单（开关/接线/卡片协议）
    - 开机日志说明：PN532 F/W x.y 出现才说明读卡器接对了
    - README 补「首次上机检查」7 步：拨码开关（含 SEL0/SEL1 对照表，
    不同厂家丝印不同）、最少接线、编译依赖、开机日志、probe、
    完整登记流程、防拿错卡验证
    - 提醒只认 ISO14443A，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
2026-10-11 fix: 修两个致命编译错误（BOM + include 顺序）——尚未上机测试
    1) 去掉 sketch_sep6a.ino 开头的 UTF-8 BOM
    BOM (EF BB BF) 会被 Arduino 预处理当成不可见字符拼到第一行 #define 前，
    报 stray '#' in program / '<U+FEFF>' does not name a type；
    更要命的是它会让本文件所有 #define 失效，连带产生
    TFT_SCK was not declared、HardwareI2C does not name a type、
    DataWrapperT 抽象类等一连串假错误。
    2) #include <SD.h> 移到 #include <LovyanGFX.hpp> 之前
    LovyanGFX 的 esp32/common.hpp 用 #if defined(_SD_H_) 决定是否生成
    DataWrapperT<fs::SDFS> 特化（#define LGFX_FILESYSTEM_SD SD）。
    原先 Lovya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
    [sketch_sep6a.ino]
2026-10-24 feat: 加状态页 + 可选状态灯，顶替板上没有的指示灯——尚未上机测试
    用户反馈：买的模块没有指示灯，不知道系统运行状况。
    改动:
    1) 开机先弹「状态页」，一屏看清各环节:
    屏幕 / 读卡器 / SD卡 / 字库 / 学生数 / 作业 / 已交
    - 全绿 → 4 秒后自动回刷卡界面
    - 有红字 → 停在状态页不动（出问题的就是它）
    2) 串口新增 `t` 命令: 调出/关闭状态页, 并打印更详细的串口报告
    (含 PN532 固件版本、当前模式、已启动秒数、空闲内存 KB)
    3) 新增可选状态灯: `#define LED_PIN -1` 改成实际 GPIO 号即可
    常亮=正常 / 慢闪=读卡器没接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
    [sketch_sep6a.ino]
2026-10-24 feat: 字库文件名不再强制 + 新增 vlw 检查工具——尚未上机测试
    用户反馈：自己下载了一个 .vlw 字库放进 SD 卡，卡里就这一个文件。
    1) initFont() 不再只认 /font.vlw:
    优先 /font.vlw; 没有就扫 SD 卡根目录, 取第一个 .vlw（大小写不敏感）。
    文件名不用改, 下载的 vlw 直接丢进卡根目录即可。
    2) 新增 looksLikeVlw(): 读文件头 4 字节识别 TTF/OTF/WOFF,
    防止"改了后缀的 .ttf"被当 vlw 解析, 给出明确提示。
    3) 新增 listSdFiles(): 列出 SD 卡根目录文件; 找不到字库时自动打印,
    并新增串口命令 `ls`（登记模式下也支持）。
    4) 状态页/串口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
2026-10-24 fix: 串口控制台重构（只走 UART0）+ 心跳 + 自定义引脚支持——尚未上机测试
    用户反馈：串口输入没反应。本机情况：**只有 Serial0(UART0) 能用，Serial(USB CDC) 用不了**。
    排查结论:
    - 设备实际枚举在 **COM3**（USB-SERIAL CH340），而 参数.xlsx 里写的 COM4 是旧值 —— IDE 里选错口是首要嫌疑。
    - 固件里三个真问题:
    1) Serial0.printf() 没被 HardwareSerial 重写，走 Print::printf -> vprintf -> stdout
    -> SDK 控制台，和 println 不是同一条路。已自己实现 printf 统一出口。
    2) setup() 里的 while (!Serial0) delay(10) 有风险（USB CDC 那种"等主机连上"
    的行为会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
    [sketch_sep6a.ino]
2026-10-25 fix: 三个真 bug —— VLW 字库被绕过 / 登记模式吞命令 / 命令被遮蔽——尚未上机测试
    用户反馈「还是不能控制」。这轮查出 3 个独立的实打实的 bug：
    ### 1. ★ VLW 字库加载了却从来没用上（这就是"一直显示内置字体"的真因）
    printCentered() / printRight() 直接调 drawText() —— 那是内置 16x16 点阵渲染器，
    完全绕过了 LovyanGFX 的 VLW。而整个 UI 几乎全用 printCentered。
    所以 SD 卡上的 font.vlw 加载成功了、串口也打印了 "vlw loaded"，
    屏幕上却还是内置点阵。现改为 useTTF 时走 lcd.setCursor + lcd.print。
    ### 2. ★ 登记模式吞掉所有不认识的命令
    han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
    [sketch_sep6a.ino]
2026-10-25 fix: SD 卡挂载失败的真因 —— SPI 主机和屏幕撞了——尚未上机测试
    现象：状态页显示「SD卡 挂载失败」+「字库 内置点阵」。
    ### 真因：SPI 主机冲突
    ESP32-S3 的 SPI 控制器只有 3 个：SPI0(flash/PSRAM) + SPI1 + SPI2，**没有 SPI3**。
    - IDF 编号：SPI1_HOST=0 SPI2_HOST=1 SPI3_HOST=2
    - Arduino 核心在 S3 上的宏：FSPI=0 (=SPI1_HOST) HSPI=1 (=SPI2_HOST)
    - LovyanGFX 屏幕默认：spi_host = SPI2_HOST (=1)
    - 原代码 SD 卡：SPIClass sdSPI(HSPI) → HSPI 在 S3 上也是 **1**
    → 屏幕和 SD 卡抢同一条总线，两个库各自调 spi_bus_initialize()，
    第二次直接失败，**SD 卡 100% 挂不上**。
    （原注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
    [sketch_sep6a.ino]
2026-10-25 fix: readPassiveTargetID 无限阻塞导致主循环卡死；回退错误的 SPI 改动——已上机实测
    ### ★ 真因：读卡函数没传 timeout，主循环被永久挂起
    Adafruit_PN532 的 readPassiveTargetID() 签名是
    bool readPassiveTargetID(..., uint16_t timeout = 0);
    // timeout 0 means no timeout - will block forever.
    代码里 4 处调用全用了默认值（= 永远阻塞）。开机进登记模式后第一次读卡就卡死，
    心跳只打一条就停，串口再也不响应 —— 这就是"不能控制 / 都看不见"的真正原因。
    4 处全部加超时：登记/写卡/收作业 50ms 轮询，probe 的 10 秒扫描循环 100ms。
    ### 回退上一轮错误的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
    [sketch_sep6a.ino]
2026-10-25 feat: 新增 sdtest 低层 SD 探测，定位到 ACMD41 初始化失败——已上机实测
    用户确认 SD 卡是外接 3.3V 兼容模块。
    ### 新增 `sdtest` 串口命令
    绕过 SD 库，直接用 SPI 发 CMD0 / CMD8 / CMD58 / CMD55+ACMD41，
    每一步打印 R1 和关键数据，一次性分清"接线问题"还是"格式问题"。
    CS 释放前后都补时钟（少发时钟会让卡片状态机卡住）。
    ### 实测结果（COM3 实跑）
    CMD0 (复位) -> R1=0x01 OK 卡片应答
    CMD8 (电压检查) -> R1=0x01 回显=000001AA OK SDHC/SDXC 卡
    CMD58 (读 OCR) -> R1=0x01 OCR=00FF8000 电压位=3.2~3.3V
    第1~5次: CMD55=0x01 ACMD41=0x01 （始终停在 idle）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
    [sketch_sep6a.ino]
